fnc765/aki300yenLCD-raspico2w/hardware/review/compact-usbc-placement-2026-09-16/placement-3d.png

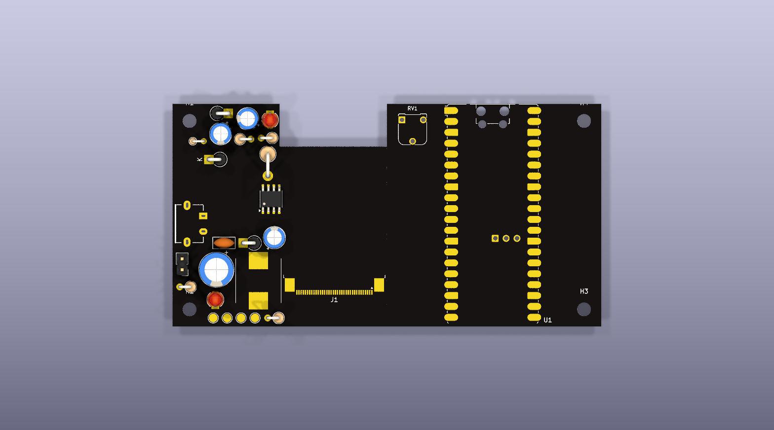
hardware/review/compact-usbc-placement-2026-09-16/placement-3d.png
