fnc765/aki300yenLCD-raspico2w/hardware/review/power-placement-2026-09-08/native-top.png

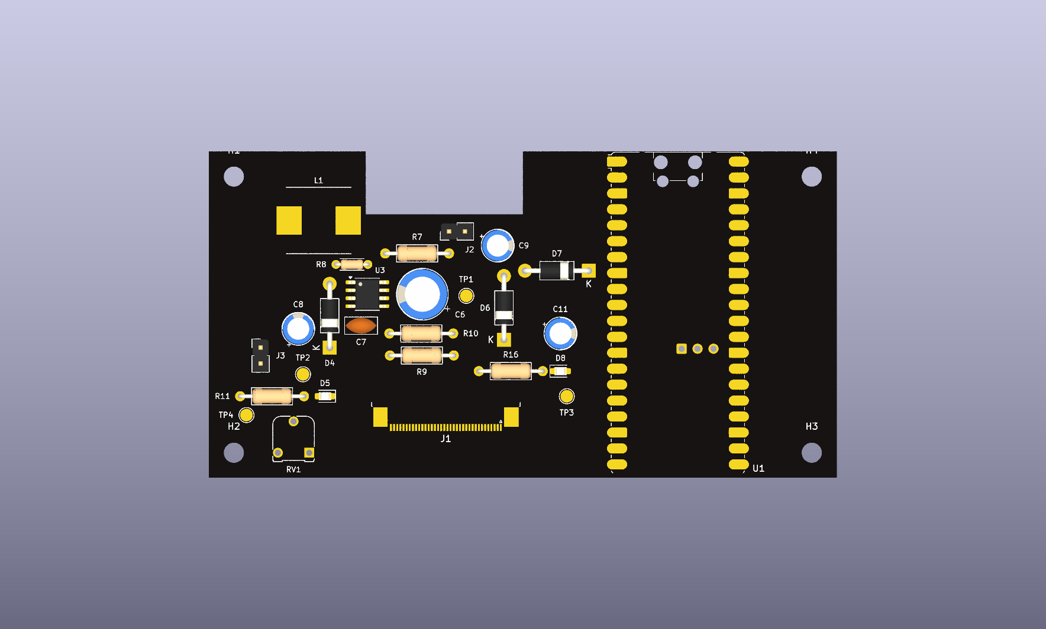
hardware/review/power-placement-2026-09-08/native-top.png
