fnc765/aki300yenLCD-raspico2w/hardware/power-placement-review.md

# 電源部の部品配置レビュー（2026-09-08、2026-09-16更新）

変更前を `f21348d` にコミットした後の配置・配線変更。基板は100×52 mm、上辺に既存の切り欠きを持つ。Pico/U1、LCD/J1、四隅の取付穴、Pico内の禁止領域、回路図・BOM・部品値・パッドのネット割当は保持した。電源関係24部品（コネクタ・テストポイント含む）をユーザー指定の赤枠領域だけへ移し、2026-09-16に電源部だけを配線した。Pico/U1とLCD/J1のフットプリントおよび配線領域には手を入れていない。RV1はユーザーが手動調整した `(53.5, 3.76) mm` を保持した。

## 調査と採用した方針

- [onsemi AN920、p.21](https://www.onsemi.com/pub/Collateral/AN920-D.PDF)：大電流ループを短く太くし、低電流の帰還／制御GNDとスイッチングGNDの戻りを入力コンデンサまで分ける。分圧抵抗をICへ近づける。
- [TI SLVA773、p.2–4](https://www.ti.com/lit/an/slva773/slva773.pdf)：昇圧では整流器・出力コンデンサ・スイッチのループを優先する。L1とSWノードを小さくまとめ、FBを離す。これは別ICを用いた一般的な昇圧配置指針なので、MC34063の実際の端子・外付けダイオードに読み替えた。
- [TI MC34063A、p.17](https://www.ti.com/lit/gpn/mc34063a)：帰還と入力デカップリング経路を短くする。掲載配置例は降圧であり、その形を昇圧基板へそのままコピーしていない。
- [onsemi MC34063 AN920](https://www.onsemi.com/download/application-notes/pdf/an920-d.pdf)：電流制限検出電圧は約330mV。R7=0.47Ωからピーク電流の設計目安を約0.70Aと見積もった。これは部品ばらつきとICしきい値を含まない配線幅選定用の概算である。
- [TI Working with Boost Converters, SNVA731](https://www.ti.com/lit/pdf/snva731)：スイッチ、整流ダイオード、出力コンデンサの高di/dtループを短く太くし、帰還を出力コンデンサ側から取り出す方針を採用した。
- [TI AN-1229, SNVA054C](https://www.ti.com/lit/an/snva054c/snva054c.pdf)：1oz銅箔・温度上昇20℃の例で4Aに約1.4mmを用いる資料を保守的な基準として参照した。本基板では約0.70A目安の主電力経路を1.0mm、端子・チャージポンプ・テスト経路を0.6mm、制御線を0.25～0.30mm、表示LEDだけを0.20～0.30mmとした。
- [Analog Devicesのスイッチングレギュレータ配置解説](https://www.analog.com/en/resources/technical-articles/basic-switchingregulatorlayout-techniques.html)：大電流の電力GNDと帰還・タイミングの静かな戻りを分け、最後に低インピーダンス面へ接続する考え方を採用した。
- [秋月電子 A295-CTRPB-1（116895）](https://akizukidenshi.com/catalog/g/g116895/)：5V入力を小型・低価格の電源専用Type-Cメスコネクタへ変更し、公式寸法図に基づく専用スルーホールフットプリントを作成した。基板左端からケーブルを挿せる向きでJ2を左外周へ配置した。
- [秋月電子 USB Type-C給電資料](https://akizukidenshi.com/goodsaffix/powered_by_type-c.pdf)：116895は内部にもCC1/CC2接点がなく、Type-C電源側からは給電されない。R17/R18を削除し、USB-A電源とA-to-Cケーブルで5Vを供給する前提を回路図・BOMへ明記した。

2026-09-16の赤枠制約更新では、部品のF.CrtYd全体が `X=0.4..26.6 mm, Y=0.4..51.6 mm` に入ることを必須条件にした。上辺切り欠き `X=25.0..26.6 mm, Y=0..10 mm`、固定したH1/H2/J1、および対象部品同士を障害物として扱い、数理配置では0.20 mm、最終読み戻しでは0.15 mmのコートヤード余白を確認した。U3/D4/L1/C8の昇圧ループ、D6/D7/C9/C11の反転電源経路、USB-CのVBUS/GND経路を重み付きで評価し、探索結果をKiCad DRCと画像で再確認して採用した。

アキシャル抵抗R7/R8/R9/R10/R11/R16はすべて縦置き、DO-41ダイオードD4/D6/D7もすべて縦置きに変更した。TP1～TP4は下外周に1列でまとめ、13V8端子J3は左外周へ配置した。密集領域の参照番号とD4/D7の極性文字はF.Fabへ移し、シルク重なりを避けた。

## 定量比較

数値はパッド中心の直線距離。実配線長や電源性能の測定結果ではない。

| 経路 | USB-C更新直後の仮置き mm | 最終配置 mm |
|---|---:|---:|
| U3 SW → D4 A | 94.792 | 5.029 |
| D4 K → C8 + | 89.985 | 4.757 |
| C8 GND → U3スイッチGND | 9.988 | 9.550 |
| L1 → U3 SW | 11.394 | 9.655 |
| R7検出側 → U3 pin7 | 66.007 | 4.505 |
| C6 → U3 VIN / GND | 12.838 / 21.209 | 12.695 / 17.739 |
| C7 → U3 pin3 | 7.548 | 4.187 |
| R9/R10 → U3 pin5 | 111.906 / 98.296 | 4.473 / 8.653 |
| C9 → D6/D7 | 96.109 / 103.728 | 4.054 / 8.818 |
| U3 SW → C9 | 12.726 | 11.287 |

小型USB-Cコネクタを含む24部品を赤枠内へ収め、実配線に合わせて最終配置を詰めた。主電力経路と空間のある±13V8主幹は1.0 mm、J1直下の制約部は0.60 mm、制御線は0.25～0.30 mm、低電流の表示LED分岐は0.20 mmとした。電源部とロジック部のGNDはF.Cu/B.Cu両面のベタへ更新し、パッドをサーマル接続、ビアをダイレクト接続とした。FBとタイミング回路はSWノードから離して独立配線した。C9は`SW_NODE`へ接続し、D6/D7/C9/C11の負電源経路を短くまとめた。表の数値はパッド中心距離であり、電源性能・温度・EMIの実測完了を意味しない。

## 検証と残件

- 2026-09-16 電源部配線後の最終ERCは0件。基板全体のDRCは13件、未配線は47件。電源部については短絡・同層交差・クリアランス・穴クリアランス・銅箔端・ダングリング・ソルダーマスクブリッジ・未配線がすべて0件。
- 対象24部品のコートヤードが赤枠内に完全に入り、上辺切り欠き・固定部品・対象部品同士とのコートヤード干渉が0件であることを、配置スクリプトの読み戻し検証で確認した。
- C9の＋端子を`+13V8`から`SW_NODE`へ修正し、回路図・基板・生成スクリプトを一致させた。出力ネットリストでもC9 pin 1、D4 pin 2、L1 pin 1、U3 pin 1が同じ`SW_NODE`に属することを確認した。
- D5/D8を3mm砲弾型THT LEDへ変更した。D5は秋月電子 111635（OSG5TA3Z74A、緑）、D8は111577（OSR5JA3Z74A、赤）で、フットプリントはともに`LED_THT:LED_D3.0mm`。C7は秋月電子 131236（RDE5C1H471J0P1H03B、470pF、50V、C0G、±5%、リード間隔2.5mm）をBOMへ反映した。
- J2は秋月電子116895（A295-CTRPB-1）へ変更し、J2 pin 1=`+5V`、pin 2=`GND`を確認した。CC端子は部品内部にも存在しないためR17/R18を削除した。USB-C電源とのC-to-C接続には使用できず、USB-A電源とA-to-Cケーブルを使う。
- 2026-09-16対象部品について、基板上のパッド番号とネット割当をKiCad読み戻しで確認した。
- 電源部配線時に残していたPico/LCD側47件の未配線は、後続の全体配線で解消した。U1/J1のフットプリント定義が入力基板から変化していないことも読み戻しで確認した。
- 2026-09-17の最終DRCに残る13件はライブラリ不一致9件、シルク端2件、禁止アイテム1件、シルク重なり1件。未配線、サーマル不足、短絡、クリアランス、穴クリアランス、銅箔端、ダングリング、ソルダーマスクブリッジは0件。
- 基板外にあった下書き注記と古い区切り線はDwgs.Userへ移した。文字・図形の内容は残した。

## 再現と出力

`place_power_stage.py`をKiCad 9付属のpython.exeで実行して固定配置を適用し、続けて`route_power_stage.py`で電源部だけを配線する。通常の更新では古い全体生成スクリプトから基板全体を再生成しない。両スクリプトとも`--input`と`--output`を指定でき、`--report`で配置・配線の検証記録を出力できる。配線スクリプトは既存トラック／ビアがある入力を拒否し、Pico/LCD側へ誤って追記しない前提を明示する。既配線基板への今回の差分は`upgrade_ground_power.py`でフェイルクローズに適用する。

`optimize_power_placement.py`は候補比較用。赤枠、上辺切り欠き、固定部品、コートヤード、重要な端子間距離、SW配線と感度の高い部品の交差を評価した。最終配置はDRCと画像確認を経て固定したもので、探索スコアだけで承認していない。

`review/power-placement-2026-09-08/`に最終DRC/ERC、検証JSON、KiCad純正SVG、その無加工ラスタライズPNG、純正3D PNGを保存。画面取得機能がWindows ACLエラーで起動できなかったため、画像はGUIスクリーンショットではなくKiCad公式出力。3Dモデルが未登録の部品は3D画像ではパッドのみになるため、実装外形は2D図で確認する。

2026-09-16更新分のERC、DRC、ネットリスト、KiCad純正SVGおよびPNGは`review/power-update-2026-09-16/`に保存した。

赤枠再配置の最終座標、境界検証、ERC/DRC、KiCad純正SVGと確認用PNGは`review/red-zone-placement-2026-09-16/`に保存した。

USB-C・縦置き・外周端子更新の最終座標、ネットリスト、ERC/DRC、KiCad純正SVGおよび3D PNGは`review/usbc-vertical-placement-2026-09-16/`に保存した。
秋月電子116895への小型化更新後の最終座標、ネットリスト、ERC/DRC、KiCad純正SVGおよび3D PNGは`review/compact-usbc-placement-2026-09-16/`に保存した。

電源部配線後の配置・配線レポート、ERC/DRC、検証JSON、KiCad純正SVGおよび3D PNGは`review/power-routing-2026-09-16/`に保存した。
