fnc765/aki300yenLCD-raspico2w/docs/datasheet-LTA042B010F.md

# LTA042B010F データシート（コミュニティ調査まとめ）

> **注意**: 東芝の正式データシートは非公開です。以下はコミュニティによるリバースエンジニアリング情報をまとめたものです。

## 基本仕様

| 項目 | 値 |
|---|-----|
| 型番 | LTA042B010F |
| メーカー | 東芝 (Toshiba) |
| パネル種別 | カラー TFT LCD |
| 解像度 | 400 × 96 ドット |
| パネルサイズ | 110mm × 30mm（横長） |
| 色深度 | RGB各6ビット（18ビット、約26万色） |
| インターフェース | RGB パラレル (RGB666) |
| コネクタ | 0.5mm ピッチ 40ピン FPC (実質36ピン使用) |
| バックライト | CCFL（冷陰極管）、専用インバーター必要 |
| 用途 | アミューズメント機器（パチンコ・パチスロ等） |
| 製造国 | 日本 |
| 発売時期 | 2006年12月 |

## 購入情報

| 項目 | 値 |
|---|-----|
| 販売店 | [秋月電子通商](https://akizukidenshi.com/catalog/g/g101703/) |
| 販売コード | 101703 |
| 価格 | ¥200（税込） |
| LCD+インバーターセット | [101705](https://akizukidenshi.com/catalog/g/g101705/) ¥300 |
| FPC DIP化基板 | [110187](https://akizukidenshi.com/catalog/g/g110187/) ¥300 |
| CCFLインバーター単体 | [111545](https://akizukidenshi.com/catalog/g/g111545/) ¥150 |

## ピンアサイン（CN1 / 40ピンFPC, 0.5mmピッチ）

| ピン | 記号 | 機能 | 備考 |
|---|---|---|---|
| 1 | TEST | テストパターン表示 | L=通常表示, H=テストパターン |
| 2 | NCLK | ドットクロック（ピクセルクロック） | **立ち下がりエッジ**でデータサンプル |
| 3 | GND | GND | |
| 4 | HSYNC | 水平同期入力 | |
| 5 | VSYNC | 垂直同期入力 | |
| 6 | 不明 | 不明（モード切替?） | **L固定推奨**、Hで挙動変化 |
| 7 | GND | GND | |
| 8 | B5 | 青データ MSB | |
| 9 | B4 | 青データ | |
| 10 | B3 | 青データ | |
| 11 | B2 | 青データ | |
| 12 | B1 | 青データ | |
| 13 | B0 | 青データ LSB | |
| 14 | GND | GND | |
| 15 | G5 | 緑データ MSB | |
| 16 | G4 | 緑データ | |
| 17 | G3 | 緑データ | |
| 18 | G2 | 緑データ | |
| 19 | G1 | 緑データ | |
| 20 | G0 | 緑データ LSB | |
| 21 | DVDD | ロジック用電源 | 3.3V or 5V |
| 22 | R5 | 赤データ MSB | |
| 23 | R4 | 赤データ | |
| 24 | R3 | 赤データ | |
| 25 | R2 | 赤データ | |
| 26 | R1 | 赤データ | |
| 27 | R0 | 赤データ LSB | |
| 28 | AVDD | アナログ用電源 | DVDDと同じ電圧推奨 |
| 29 | VCPP_ADJ | コントラスト微調整（Vo） | 0〜3V入力、入力Z≈10kΩ |
| 30 | GND | GND | |
| 31 | GVDD | LCDゲートドライバロジック電源 | 5V推奨 |
| 32 | GND | GND | |
| 33 | VSS | LCDゲート負電源 | **−9V〜−15V** |
| 34 | GND | GND | |
| 35 | VGON | LCDゲート正電源 | **+9V〜+15V** |
| 36 | GND | GND | |
| 37-40 | NC | 未使用 | |

> **注意**: 秋月電子の参考資料ではRGBのビット番号(MSB/LSB)が逆に振られている場合があります（naruken氏指摘）。上記は実測に基づく正確なアサインです。

### 信号配置の特徴

- **RGB の並び順**: B → G → R（ピン番号順）
- **DE（データイネーブル）信号は存在しない**: HSYNC/VSYNC モードのみ
- **NCLK は立ち下がりエッジ**でサンプリング（注意）

## タイミング仕様

### 水平タイミング

| パラメータ | Min | Typ | Max | 単位 | 備考 |
|---|-----|-----|-----|---|---|
| H active (表示期間) | 400 | 400 | 400 | clk | 固定 |
| H back porch | 107 | 107 | 107 | clk | HSYNC→表示開始 |
| H front porch | 3 | 97 | 197 | clk | 表示終了→次HSYNC |
| H total (1ライン) | 510 | 604 | 604 | clk | |
| H total (自動) | - | 560 | - | clk | 同期信号なし時 (107+400+53) |

### 垂直タイミング

| パラメータ | Min | Typ | Max | 単位 | 備考 |
|---|-----|-----|-----|---|---|
| V active (表示期間) | 96 | 96 | 96 | lines | 固定 |
| V back porch | 16 | 16 | 16 | lines | VSYNC→表示開始 |
| V front porch | 0 | - | N | lines | 可変、最小0 |
| V total (自動) | - | 561 | - | lines | 同期信号なし時 |

### 同期信号

| 信号 | 検出条件 | 動作 |
|---|---|---|
| HSYNC | NCLKの**立ち下がり**でサンプル、H→L遷移で同期開始 | Xアドレスリセット、Yインクリメント |
| VSYNC | HSYNC開始から**98クロック後**のNCLK立ち下がりでサンプル | X, Yアドレスリセット |

> **重要**: VSYNC は HSYNC 開始から 98 クロック後にサンプリングされる。任意のタイミングでアサートしても無視される。

### ピクセルクロック実用例

| フレームレート | H_total | V_total | DCLK |
|---|---|---|---|
| 30 Hz | 512 clk | 112 lines | **1.72 MHz** |
| 60 Hz | 512 clk | 112 lines | **3.44 MHz** |
| 60 Hz | 560 clk | 112 lines | **3.76 MHz** |

## 電気的特性

### 電源仕様

| 電源ピン | 電圧 | 備考 |
|---|---|---|
| DVDD (Pin 21) | 3.3V or 5V | ロジック電源。5V推奨（内部74HC590A使用） |
| AVDD (Pin 28) | DVDDと同じ | アナログ電源 |
| GVDD (Pin 31) | DVDDと同じ | ゲートドライバロジック電源 |
| VGON (Pin 35) | **+9V〜+15V** | ゲート正電源。高いと色保持時間が延びる |
| VSS (Pin 33) | **−9V〜−15V** | ゲート負電源。低いと色保持時間短い |

### 動作確認済み電源組み合わせ

| 構成 | DVDD | AVDD | GVDD | VGON | VSS | 入力レベル |
|---|---|---|---|---|-----|---|
| 5V構成 | 5V | 5V | 5V | +12V | -12V | CMOS |
| 3.3V構成A | 3.3V | 3.3V | 5V | +12V | -12V | LVCMOS |
| 3.3V構成B | 3.3V | 3.3V | 3.3V | +12V | -12V | LVCMOS |

> **Pico 2W (3.3V) との直接接続**: 3.3V構成B で動作可能。GVDD に別途 5V 供給が望ましい。

### コントラスト調整

- **VCPP_ADJ (Pin 29)**: 0〜3V のアナログ電圧で微調整
- 入力インピーダンス ≈ 10kΩ（低い）
- Vo=0V or Hi-Z にすると、値15付近で飽和 → **RGB各4bit（12bitカラー）** として使用可能
- **VR1（基板背面）**: フリッカー調整用。グレースケール表示でフリッカーが最小になるよう調整

### 内部IC

| IC | 型番 | 機能 |
|----|---|---|
| IC1 | KZ3H013304 | LCD タイミングコントローラ |
| IC2 | VHD04 | アナログ関連 |
| IC5 | 74HC590A | シフトレジスタ/カウンタ |
| TR2-TR5 | チップTr | ダイヤモンドバッファ（VCOM供給） |

## バックライト

| 項目 | 値 |
|---|-----|
| 種類 | **CCFL（冷陰極管）** |
| 駆動方式 | DC-ACインバーター（数百V AC） |
| 推奨インバーター | 秋月 DC12V冷陰極管インバーター (111545, ¥150) |
| 入力電圧 | DC 12V |
| 注意事項 | バックライトなしでは暗すぎて視認不可。高電圧に注意。 |

## 接続の簡易構成

### フル接続（18bit RGB666 + 制御）

```
[マイコン/FPGA]
  GPIO × 18本 → R[5:0], G[5:0], B[5:0]  (RGBデータ)
  GPIO × 1本  → NCLK (ドットクロック、タイマ出力推奨)
  GPIO × 1本  → HSYNC (水平同期)
  GPIO × 1本  → VSYNC (垂直同期)
  GPIO × 1本  → TEST (L固定)
  Pin 6       → L固定 (GND)
合計: 22 GPIO (TEST/Pin6をGND固定すれば20 GPIO)

[電源]
  +5V     → Pin 21(DVDD), Pin 28(AVDD), Pin 31(GVDD)
  GND     → Pin 3, 7, 14, 30, 32, 34, 36
  +12V    → Pin 35 (VGON)
  -12V    → Pin 33 (VSS)
  DC 12V  → CCFLインバーター → バックライト

[調整]
  Pin 29(VCPP_ADJ) → 可変抵抗(10kΩ)で 0〜3V
```

### 簡易接続（12bit RGB444 + 制御）

```
  R[3:0], G[3:0], B[3:0] = 12本
  R[5:4], G[5:4], B[5:4] = GND固定
  NCLK + HSYNC + VSYNC   = 3本
合計: 15 GPIO
Pin 29(VCPP_ADJ) = 0V or Hi-Z
```

## テストパターン機能

Pin 1 (TEST) を H にすると、G[5:0] の値でテストパターンを表示可能。
動作確認に便利。マイコンなしでもテストパターンで表示を確認できる。

## 重要な注意事項

1. **NCLKを停止してはいけない** — 液晶パネルが損傷する可能性（LTAシリーズ共通）
2. **バックライト(CCFL)は高電圧** — 感電注意、絶縁対策必須
3. **フレームバッファは内蔵されていない** — 常にリフレッシュデータを送り続ける必要がある。DMA必須
4. **秋月のピン番号に注意** — RGB の MSB/LSB が逆に振られている場合あり
5. **ダイヤモンドバッファ(TR2-TR5)** — ハンダ不良で電源ショートすると発煙。1個壊れると表示不可
6. **DC-DCコンバーターのノイズ** — ±12V生成時、液晶に表示ノイズが乗る可能性あり
7. **VGON/VSS電圧変更時** — VR1(フリッカー調整)の再調整が必要
8. **同期信号なしでも動作** — 560clk毎に自動リセットされるため、とりあえず映像出力可能

## 参考リンク

### 詳細解析サイト
- [なる研 (naruken) - LTA042B010F](http://naruken.cweb.tk/labo/lta042b010f/) — 最初の包括的解析
- [xcrosgs2wy - 秋月LCD解析](https://xcrosgs2wy.web.fc2.com/akilcd/) — 最も詳細な電気的解析

### 実装事例
- [pol - ESP32-S3で300円液晶](https://pol.hateblo.jp/entry/2023/11/27/001524) — ESP32-S3 LCD_CAMペリフェラル使用
- [mikanplus - STM32F103で300円液晶](https://www.usamimi.info/~mikanplus/stm32f/aki300.htm) — DMA+タイマで30Hz表示
- [Kyotani - AVR XMegaで300円液晶](https://kyotani-hobby.blogspot.com/2011/03/21.html) — 7回連載
- [ChaN (ELM) - 秋月3000円LCDレポート](https://elm-chan.org/junk/aki3k/report.html) — 比較・互換性検証

### 購入先
- [秋月電子 LCD単体](https://akizukidenshi.com/catalog/g/g101703/)
- [秋月電子 LCD+インバーターセット](https://akizukidenshi.com/catalog/g/g101705/)
