fnc765/aki300yenLCD-raspico2w/docs/ticker.md

# ネットワーク・ティッカー (`ticker`, v0.3.0〜、現行ソース v0.6.4)

0.6.0 で [P110M の Matter 消費電力表示](matter-power.md) を追加した。
前回の probe の登録情報を SD に引き継ぎ、Pico 2 W 単体で取得して LCD に W を表示する。

Pico 2 W + 300 円 LCD を「時計 + 天気 + 流れる文字」の小さな情報端末にする bin。
v0.4.0 から SD の写真 (BMP) をスライドショーで背景に敷き、その上に半透明の「ガラス」の板で情報を重ねる。
`wifi_ota` (v0.2.x) の後継で、**Release の OTA イメージはこれ** (`manifest.json` の `bin` が `ticker.bin`)。
OTA / TBYB の仕組みは [wifi-ota.md](wifi-ota.md) と同じ (実装は `src/ota/app.rs` に共通化した)。
v0.5.0 からは同じ LAN のブラウザで設定を変えられる (**設定ページ**、[settings-server.md](settings-server.md))。
0.5.1 からは流れる文字の後ろに毎周 `◆ 設定 http://192.168.x.y/ コード 123456 ◆` が流れる (§1.3) ので、その URL を開く
(`ticker.txt` の `show_settings=0` で入れない)。

## 1. 画面 (400×96、v0.4.0〜)

描画はハードウェアに依存しない `src/ui/` が行う。**同じコードを PC のシミュレータ `tools/ui-sim` で動かして、
書き込む前に PNG / GIF で確かめられる** ([ui-sim.md](ui-sim.md))。既定の構成 `layout=glass`:

```text
 x 8〜        y 4〜35   21:53:44   時計 (DejaVu Sans の 4 bit アンチエイリアス数字 32 px、秒は 15 px)。板なし、右下 1 px の影
              y 40〜53  9月29日(火) 日付 (東雲 14 px、影付き)
              (左上 230×70 は背景に薄い暗がりを焼き込み、明るい写真でも読めるようにする)
 x 234〜396   y 4〜57   天気のガラス板 (黒 62 % + 上辺 1 px の明るい線 + 角丸 4)
                          行 1: 天気アイコン 15×15 (晴れ / 月 / 晴れ時々くもり / くもり / 霧 / 霧雨 / 雨 / 雪 / 雷)
                                + 気温 (橙の AA 数字 19.1°)、右端に地名 (⌖東京)
                          行 2: 天気 (晴れ時々くもり、東雲 14 px)
                          行 3: ▲最高 (赤) ▼最低 (青) + 降水確率の錠剤 (💧40%、水色)
 x 4〜396     y 74〜92  流れる文字の帯 (ガラス、東雲 14 px、右→左) | 右端 118 px に小さな状態:
                          Wi-Fi の扇 + NTP WX MSG (緑 = 良好 / 黄 = 取得中 / 赤 = 失敗 / 灰 = 未取得) + v0.4.0
```

- 日本語は東雲フォント 14 ドットの等倍 (§5)。線はすべて 1 px (2 px の線は LCD のにじみで潰れるため)。
  時計・気温の数字だけは大きさが要るのでアンチエイリアスの数字フォント ([fonts/dejavu/README.md](../fonts/dejavu/README.md)) にした。
- 外周 1 px の枠は写真を全面に出すため `glass` / `dock` では描かない (表示位置 106 は v0.2.8 で確定済み。
  `classic` と `wifi_ota` には残っている)。
- 時刻同期前は `--:--` (灰) + `時刻同期中…`、天気取得前は `?` + `天気取得中…`。
- 18〜6 時は晴れ / 晴れ時々くもりのアイコンが月になる。
- `ticker.txt` の `layout=` で構成を選べる (シミュレータで比べた 3 案。v0.4.0 の既定は `glass`):

| `layout=` | 内容 |
|---|---|
| `glass` (既定) | 上記。写真の中央 (x 160〜230) と帯の上 (y 58〜73) が見え、情報は左上 (時計) / 右上 (天気) / 下 (文字) にまとまる |
| `dock` | 上 52 px は写真と時計 + 日付だけ、下 40 px のガラスの台に天気と流れる文字。写真が一番よく見えるが、天気が 1 行に詰まる |
| `classic` | 0.3.1 と同じ配置 (状態 3 行を常に表示) で、写真を全面 62 % 暗くして敷く。比較用 |

### 1.1 状態表示 (3 行 ⇔ 小さな 1 行)

0.3.1 の下 3 行 (`SSID IP | NTP | WX | MSG` / `ticker v0.4.0 via OTA slot B TBYB:...` / `OTA: ...`、`FONT_6X10`、9 px ピッチ) は
OTA の診断に欠かせないが画面の 3 分の 1 を使うので、**必要なときだけ** 下の帯の位置 (y 61〜95 のガラス板) に出す。
それ以外は帯の右端の小さな表示だけになる (流れる文字は 3 行の間は隠れる)。3 行を出す条件 (どれか 1 つ):

1. 起動から 60 s
2. 失敗から 30 s (NTP / 天気 / 文字の取得失敗、Wi-Fi の join 失敗、OTA の失敗、背景の写真が読めない)
3. 起動診断 (前回の TBYB の記録) / `ticker.txt` の注意を出している間 (60 s / 90 s)
4. Wi-Fi が IP を得ていない間
5. OTA のダウンロード中 / 検証中 / 再起動待ち (進捗バー付き) と、OTA の失敗・巻き戻り (`OTA:` 行が赤)
6. TBYB の buy 待ち (`TBYB:pending 41/180s wait:weather` / `settle 12s`、0.4.2〜 最長 180 s) / buy 失敗 / 締め切り切れ

`ticker.txt` の `status=full` で常に 3 行、`status=compact` で常に小さな 1 行 (既定 `auto` は上の規則)。
3 行の文言は 0.3.1 と同じ (下記)。

- 行 1: 起動診断 (前回の TBYB 起動の記録 `TBYB 0.3.0: dhcp-wait @121.3s ...`、無ければ `FLASH_UPDATE P1 A:... reset:wdt`
  の起動種別。電源投入直後の通常起動では出ない) → `ticker.txt` の注意 / 背景の写真の失敗 (`BG IMAGE.BMP: BMP: 24/32 bit only`) →
  `<SSID> <IP> | NTP <状態> | WX <状態> | MSG <状態>`
  - `NTP ok s1` = 同期済み (stratum 1)、`syncing`、`DNS failed` / `timeout` / `bad reply`
  - `WX ok` / `ok(http)` (TLS が通らず平文 HTTP に切り替えた) / `fetching` / `HTTP 429` / `bad JSON` / `too long`
  - `MSG ok` / `ok(cut)` (512 B で切った) / `fetching` / `HTTP 404` / ...
- 行 2・3 は `wifi_ota` の行 1・2 と同じ文言・色 (`src/ota/app.rs` が作る)。**OTA の診断はこの 2 行で行う**。
  ダウンロード中は行 3 の上に進捗バーが出る。

### 1.2 背景の写真 (スライドショー)

- SD のルートの `*.BMP` (8.3 名、名前順、最大 16 枚。`_` で始まる名前 = macOS の `._IMAGE.BMP` などは除く) を
  `slide=` 秒 (既定 30) ごとに切り替える。`images=A.BMP,B.BMP` で使う写真と順番を指定できる。
  1 枚だけ、または `slide=0` なら最初の 1 枚を出したまま。BMP が無ければ既定のグラデーション (紺 → 青紫)。
- 形式: **非圧縮の 24 bit / 32 bit BMP** (下から上 / 上から下のどちらも、32 bit は BI_RGB と標準マスクの
  BI_BITFIELDS)。8 bit (パレット) / 16 bit / RLE 圧縮 / PNG / JPEG は不可 (読めなければ状態行 1 に理由を出して次へ)。
- 大きさは任意 (最大 8192×8192)。**縦横比を保って 400×96 を覆う最小の倍率に拡大縮小し、はみ出た部分の中央を切り出す**
  (縮小は面積平均、拡大は最近傍)。ただし SD は遅い (下記) ので、**400×96 の 24 bit BMP (115 kB)** を勧める
  (`convert_image_to_bmp.py` で作れる。`sd_bmp_viewer` 用の `IMAGE.BMP` / `IMAGE2.BMP` はそのまま使える)。
- 背景用の RAM は 1 枚分 (RGB565 76.8 kB) しか無いので、切り替えは「背景だけを 0.5 s で暗くする → 暗いまま
  新しい写真を読みながら行を上書き (下から上の BMP なら下の行から現れる) → 0.7 s で明るく戻す」。
  時計 / 天気 / 流れる文字は通常の明るさのまま動き続ける。8 bit の色は Bayer 4×4 のディザで RGB565 にする。
- 読み込みの速さ: SD は GPIO のビットバング SPI。起動時 (wifi.txt / ticker.txt) は従来どおり ≈200 kHz、
  写真を読むときだけ ≈1.5〜2 MHz に上げる (`sdfast=1`、既定)。400×96 の BMP で ≈1〜2 s の見込み。
  読み誤り (CRC) が出たら自動で低速に戻して読み直す (低速だと ≈4〜5 s、その間は描画が 30 fps に落ちる)。
  1 回に読むのは 512 バイト (SD の 1 ブロック) までで、描画 1 フレームの合間に 5 ms まで読むので、読み込み中も
  時計と流れる文字は止まらない。
- OTA の確認 / ダウンロード / 検証の間は切り替えを始めず、読み込み中なら止まって待つ (フラッシュ書き込みと重ねない)。

### 1.3 流れる文字の設定 URL とコード (0.5.1〜)

設定ページ ([settings-server.md](settings-server.md)) の URL とアクセスコードを、流れる文字の後ろに毎周入れる:

```text
…流れる文字…　◆　設定 http://192.168.200.130/ コード 482913　◆　…流れる文字…　◆　設定 …
                 橙  灰    水色                    灰     水色      橙
```

- 設定の部分があるときは文字列 (文字 + 区切り + 設定 + 区切り) を **切れ目なく繰り返して** 流す (末尾の ◆ のすぐ後に先頭が続く。
  つなぎ目で位置が飛ばない。`scroll::advance` は 1 周進んだら 1 周分戻すだけ、描画は周期ごとに並べる)。文字が空なら設定の部分だけが流れる。
  設定の部分が無いとき (`show_settings=0` など) は 0.5.0 までと同じ (右端から入って左へ出切ったら右端から)。
- 入れるのは **設定ページが待ち受けている間だけ** (最初の OTA 確認が通った後。回復モードでは入れない)。IP が無い間 (Wi-Fi が切れた)
  は `設定: Wi-Fi 接続待ち`。IP / コードが変わったら次のフレームで組み直す (流れている位置はそのまま。文字が変わったときだけ右端から)。
- `ticker.txt` の `show_settings=0` (設定ページの「流れる文字に設定 URL とコードを入れる」) で入れない。
- 設定ページの「LCD にコードを表示」: 流れる文字を設定の部分が左端に来る位置へ進め、12 s だけ薄い水色の板で目立たせる。
  その後 1 分は `show_settings=0` でも入れる。状態 3 行を出している間 (起動 60 s、buy 待ちなど) は、0.5.0 と同じく行 1 にも
  `settings: http://… code …` を 1 分出す (待ち受けの開始時も)。
- Glass の帯 (264 px) には 1 度に全部は入らない (≈ 294 px)。URL の先頭からコードの末尾までは 259 px で収まる。Dock / Classic は全部見える。
- 組み立ては `src/ui/scroll.rs` の `ScrollText::compose` (static な共有モデルの中、≈ 0.8 kB。スタックには置かない)。文字 (最大 512 B) +
  設定の部分 (最大 67 B) が必ず入る大きさ (608 B) で、足りなければ文字の方を文字の境目で切る。描画タスクは入力 (文字の世代、
  URL / コードの世代、設定の部分の状態) が変わったフレームだけ組み立て直し、毎フレームは見えている部分だけを描く。
  ホストのテスト (`tools/ticker-tests` の `scroll_tests`) と ui-sim (`scenarios/settings*.json`) も同じコードを使う。

### 1.4 電力を大きく表示する・推移を見る (0.6.3〜)

設定ページの「電力表示」で通常 / 大きく / 大きく＋グラフを選べる。
`power_display=normal` は従来の配置。`large` は左側の広い枠に W を右寄せで大きく表示する。
`graph` は左側の136pxの枠に現在値を右寄せし、右の時計と高さを揃える。
数値の下に `P110M` と状態表示、余白を空けてその下に推移を表示する。
右側の時計・日付・天気の枠は右端を固定し、表示中で一番広い行に左右6pxの余白を加えた幅になる。
天気アイコン・気温・降水確率もまとめて一行として測り、天気の説明がより長ければそちらに合わせる。
詳細表示で隠れる説明は幅に含めない。グラフ表示では中央に120px以上の背景が見える余白を確保する。
両モードとも気温の右に水滴と今日の降水確率を表示する。未取得は `--%` (0% と区別)。
大型表示では Glass の下部帯を使い、状態表示とスクロールの切り替え条件 (§1.1) は同じ。
状態 3 行を表示中は上の枠を縮め、数値とグラフも収める。Matter が無効なら従来の画面を使う。

「グラフ期間」は **1分・5分・30分・1時間・6時間・24時間**。
`power_minutes=1/5/30/60/360/1440` でも設定でき、既定は 5分。
横軸は選んだ期間の過去から現在、縦軸は W (0 を含む自動調整)。未取得・通信が途切れた区間は線をつながない。
非常に大きな縦軸の値は `k` / `M` (千倍 / 百万倍) で短く表し、数字がプロット領域に重ならないようにする。

履歴は通常表示中も RAM に蓄積し、表示・期間の変更では消えない。再起動・電源断で消える。
短い期間は 5秒、6・24時間は 2分の平均値を使い、履歴・描画用の集計結果で約6.5KBの固定領域を使う。
集計は新しい取得値・期間変更・5秒の経過時だけ行い、毎フレームの通信や SD 書き込みは増やさない。
時計の時刻修正に左右されないよう、履歴の時間は起動からの経過時間で管理する。
設定ページ上のグラフは配置確認用のサンプル値で、実際の測定履歴は LCD に表示する。

## 2. データ源と更新周期

| 項目 | 取得先 | 方式 | 周期 | 失敗時 |
|---|---|---|---|---|
| 時刻 | `ntp.nict.jp` → 予備 `pool.ntp.org` (UDP 123) | SNTP v4 (RFC 4330、48 B、自前実装 `src/ticker/sntp*.rs`) | 6 時間 | 30 s → 最大 10 min |
| 天気 | `api.open-meteo.com/v1/forecast` (API キー不要) | HTTPS (TLS 1.3 / AES-128-GCM / RSA-PSS、GitHub と同じ設定)。TLS 失敗時は次回から `http://` (Open-Meteo は平文も受ける) | 30 分 | 2 分 |
| 流れる文字 | `ticker.txt` の `message_url` (既定: このリポジトリの `ticker/message.txt`、raw.githubusercontent.com) | HTTPS (200 直返し、リダイレクト無し) | 5 分 | 1 分 |
| OTA | GitHub Release の `manifest.json` → `ticker.bin` | HTTPS (wifi_ota と同じ) | 60 秒 | 60 s → 最大 10 min |

- 時刻は同期時の UNIX ミリ秒 + embassy の単調時計 (`Instant`) で進める。表示は固定オフセット
  (`ticker.txt` の `tz`、既定 +9 = JST)。夏時間は扱わない。
- 天気の要求は `current=temperature_2m,weather_code&daily=temperature_2m_max,temperature_2m_min,
  precipitation_probability_max&timezone=auto&forecast_days=1` (本文 ≈ 620 B、chunked)。
  `serde-json-core` で `current` / `daily` だけ読む。WMO 天気コードは `src/ticker/weather.rs` で
  日本語にする (0 快晴、1 晴れ、2 晴れ時々くもり、3 くもり、45/48 霧、51〜55 霧雨、61/63/65 小雨/雨/大雨、
  71/73/75 小雪/雪/大雪、80〜82 にわか雨、95 雷雨、96/99 雷雨とひょう …)。
  Open-Meteo の無料枠は 1 日 10,000 要求 / IP なので 30 分周期 (48 回/日) は十分余裕がある。
- 流れる文字は UTF-8 テキストをそのまま 1 行に流す (改行は空白に)。512 バイト (日本語 ≈ 170 文字) で切る。
  内容が変わったときだけ右端から流し直す。**`ticker/message.txt` を main で書き換えれば、5 分以内に
  全機体の表示が変わる。**
- 取得は 1 本の TLS バッファ (16 kB + 3 kB) を共用するため、取得タスク `jobs_task` (250 ms 周期、0.4.1〜。
  0.4.0 までは main ループ) が OTA → NTP → 天気 → 文字 の優先順で**一度に 1 つずつ**行う。OTA のダウンロード中
  (数十秒〜数分) は他の取得は待つ。
- **接続後の最初の仕事は OTA 確認** (0.4.1〜)。最初の確認が終わる (成否を問わない) まで NTP / 天気 / 文字も
  写真の読み込みも始めない。新しい版にどこかで止まる不具合があっても、起動するたびに OTA 確認までは
  進むので、次の版を配れば直る (§8)。Wi-Fi が無い / つながらない場合、写真は起動 45 s 後に始める。

## 3. TBYB と OTA

- 自己診断 (buy 条件) は 0.4.2 から「Wi-Fi + DHCP、OTA の manifest 確認 (TLS + HTTP)、NTP / 天気 / 文字 / SD の設定 /
  最初の写真を 1 回ずつ試す (0.5.0〜 設定ページの待ち受け開始も)、その後 25 s 健全に動く」(締め切り 180 s、§8.2)。0.4.1 までは Wi-Fi + DHCP だけで、
  OTA 確認より前に buy していた (OTA の経路が壊れた版でも buy してしまう)。取得の成否は問わない (落ちずに戻ってくればよい)。
- buy 待ちの間 (OTA で届いてから 40〜60 s。状態行 2 が黄色の `TBYB:pending 41/180s wait:message` → `settle 12s`) は、
  時計・天気・文字・写真は普段どおり動く。OTA 確認は manifest を読むだけ (buy の後にダウンロード)。
- OTA イメージの切り替え: v0.2.x の `wifi_ota` は manifest の `bin` に書かれた名前をそのまま
  `releases/latest/download/<bin>` から取る (`src/ota/app.rs` の `latest_asset_url(&manifest.bin)`)。
  v0.3.0 の Release では `manifest.json` が `ticker.bin` を指すので、**0.2.8 の `wifi_ota` が動いている機体は
  そのまま `ticker` 0.3.0 をダウンロードして切り替わる**。以後の版も `ticker.bin` で配る。
  `wifi_ota.bin` / `wifi_ota.uf2` (TBYB 付き) も Release には引き続き付けるが、manifest からは参照しない。
- `ticker` から `wifi_ota` に戻したいときは USB (`wifi_ota-plain.uf2`) で書くか、manifest の `bin` を
  `wifi_ota.bin` にした Release を出す (版数は上げる必要がある)。

## 4. 設定: SD カードの `ticker.txt` (任意)

`WIFI.TXT` と同じく microSD のルートに置く (8.3 名 `TICKER.TXT`、UTF-8、BOM 可、1,536 バイトまで (0.5.0〜。0.4.x は 512))。
0.5.0 からは **設定ページ** ([settings-server.md](settings-server.md)) からも書き換えられる。ページは変えたキーの行だけを書き換え、
知らないキー / コメント / 行の順番は残す (書き込みは `TICKER.NEW` → 読み戻し → `TICKER.BAK` → `TICKER.TXT` → 読み戻し。
`TICKER.TXT` が無い / 空で `TICKER.NEW` があれば、起動時にそれを読む)。無ければ東京の既定値で動き、
起動後しばらく (起動診断の 60 s の後) 状態行 1 に `ticker.txt not found, using Tokyo (35.6812,139.7671 UTC+9)` と出る。

**ticker.txt は無くても止まらない**。無い / 空 / 読めない / SD カードが無い、のどの場合も既定値で起動を続け、
状態行 1 に理由を出すだけ (`ticker::config::load`、4 つの場合を `tools/ticker-tests` で確認している)。
0.4.0 が起動後 1 分ほどで固まったのは ticker.txt とは関係なく、最初の HTTPS (天気) でスタックが溢れたため (§8)。

| SD の状態 | 状態行 1 の注意 |
|---|---|
| `TICKER.TXT` が無い | `ticker.txt not found, using Tokyo (...)` |
| 空 (空白 / 改行だけ) | `ticker.txt is empty, using Tokyo defaults` |
| 有効なキーが無い / UTF-8 でない | `ticker.txt: no valid keys, using Tokyo defaults` |
| 読み取り失敗 | `ticker.txt: <理由>, using Tokyo defaults` |
| SD カードが無い / 初期化できない | `SD: SD INIT FAILED (ticker.txt skipped, using Tokyo)` (Wi-Fi も `wifi.txt` が無いので OTA 無し) |

```ini
# 行頭 # はコメント。key=value、キーの大文字小文字は区別しない。値の後ろの # 以降も無視
lat=35.6812          # 緯度 (-90〜90)
lon=139.7671         # 経度 (-180〜180)
tz=+9                # UTC からの時差 (時間)。9 / -5.5 / +05:30 / 9:00 の形も可。±14 まで
place=東京           # 天気の行の先頭に出す地名 (最大 32 バイト、東雲フォントにある文字)
message_url=https://raw.githubusercontent.com/fnc765/aki300yenLCD-raspico2w/main/ticker/message.txt
scroll=1             # 流れる文字の速さ (px / フレーム、1〜8。60 Hz なので 1 = 60 px/s)
slide=30             # 写真の切り替え間隔 (秒、5〜3600。0 = 切り替えない)          v0.4.0〜
images=IMAGE.BMP,IMAGE2.BMP   # 背景に使う BMP と順番 (省略時はルートの *.BMP 全部、名前順)
layout=glass         # 画面構成 glass / dock / classic (§1)
rotate=0             # 画面全体の向き: 通常 0 / 180度回転 180
power_display=normal # 電力表示: normal / large / graph (大きく＋グラフ、§1.4)
power_minutes=5      # グラフ期間 (分): 1 / 5 / 30 / 60 / 360 / 1440
status=auto          # 状態 3 行 auto (必要なときだけ、§1.1) / full (常に) / compact (常に小さな 1 行)
sdfast=1             # 写真を読むときの SD の速さ 1 = 速い (読み誤りで自動的に低速へ) / 0 = 常に低速
debug_crash=ota      # 試験用 (0.4.2〜): boot / ota / slideshow でわざと panic する (回復モードの確認用、§8)。既定は無し
message=こんにちは   # 流れる文字をこの端末で決める (0.5.0〜)。行末まで全部 (# もそのまま)。あれば message_url を取得しない
show_settings=1      # 流れる文字に設定ページの URL とアクセスコードを入れる (0.5.1〜、既定 1)。0 で入れない
```

| キー | 既定値 | 備考 |
|---|---|---|
| `lat` / `lon` | 35.6812 / 139.7671 (東京駅) | Open-Meteo に小数 4 桁で渡す |
| `tz` | +9 | 表示だけに使う。天気の「今日」は Open-Meteo が座標から決める (`timezone=auto`) |
| `place` | 東京 | 空なら既定のまま |
| `message_url` | 上記 | `http://` / `https://` で始まること。最大 256 バイト |
| `scroll` | 1 | |
| `power_display` | normal | 大型表示 `large` / グラフ付き `graph`。Matter が無効なら従来の画面 |
| `power_minutes` | 5 | 1 / 5 / 30 / 60 / 360 / 1440 (分)。表示の変更でも履歴は残る |
| `slide` | 30 | 0 なら最初の 1 枚のまま (v0.4.0〜) |
| `images` | (ルートの *.BMP) | カンマ区切り、8.3 名、最大 16。正しい名前が 1 つも無ければ無視 |
| `layout` | `glass` | `glass` / `dock` / `classic` |
| `rotate` | 0 | `0` = 通常、`180` = 画面全体を180度回転。デバイスを逆さに置く場合に使う。設定ページから保存すると次のフレームから反映し、再起動後も保持する |
| `status` | `auto` | `auto` / `full` / `compact` |
| `sdfast` | 1 | `0` / `1` |
| `message` | (無し) | 0.5.0〜。512 バイトまで。空 / 行が無ければ `message_url` から取得。設定ページの「この端末で決める」が書く |
| `show_settings` | 1 | 0.5.1〜。`0` / `1`。設定ページの「流れる文字に設定 URL とコードを入れる」が書く (§1.3)。**1 の間は LCD を見られる人なら誰でも設定を変えられる** ([settings-server.md §4](settings-server.md)) |
| `debug_crash` | (無し) | `boot` (ticker.txt を読んだ直後) / `ota` (最初の OTA 確認の直前) / `slideshow` (最初の写真を読み始めたとき) / `none`。**buy 済みの版の通常起動でだけ効く** (TBYB の buy 待ちと回復モードでは無視。回復モードは ticker.txt を読まない)。2 回で回復モードになり、10 分ごとに通常モードを試してまた落ちる。消せば次の通常モードの試行で元に戻る |

不正な値のキーは無視して既定値のまま。有効なキーが 1 つも無ければ `ticker.txt: no valid keys, ...` と出る。

## 5. 日本語フォントとライセンス

- /efont/ プロジェクトの**東雲フォント** (Shinonome) 0.9.11、ゴシック体 14 ドット (`shnmk14` JIS X 0208 全角 14×14 +
  `shnm7x14r` JIS X 0201 半角 7×14) を `tools/bdf2bin.py` で 3 つのテーブル (`fonts/shinonome/codes.bin` 14,094 B +
  `glyphs.bin` 197,316 B + `widths.bin` 7,047 B、計 218,457 B、7,047 グリフ = JIS 第一・第二水準 + かな + 記号 +
  半角 ASCII / 半角カナ) に変換し、フラッシュに埋め込む (`src/font/shinonome.rs`、Unicode の二分探索、等倍描画)。
  取得元は Debian / Ubuntu の `xfonts-shinonome` パッケージ (PCF → `pcf2bdf`)。
- ライセンスは **Public Domain** (作者が権利を行使しないと宣言。改造・変換・組込み・再配布自由、無保証)。
  原文は [fonts/shinonome/LICENSE](../fonts/shinonome/LICENSE)、由来は [fonts/shinonome/README.md](../fonts/shinonome/README.md)。
- **v0.3.1 で美咲フォント (8×8) の 2 倍表示から置き換えた理由**: 実機の写真で、2 倍にした線 (2 px) が
  隣の線との隙間 (2 px) を LCD の画素のにじみで埋めてしまい、「太すぎて潰れて」見えた。ASCII の `FONT_6X10` や
  時計の数字 (5×7 ×4 は線が 4 px だが隙間も 4 px) は問題なかったので、線 1 px・隙間 1 px 以上の等倍 14 ドット
  フォントに変えた。文字の大きさ (全角 14 px) は美咲 ×2 の字面 (7×7 ×2 = 14 px) と同じで、レイアウトは変えていない。
  16 ドットの東雲 (`shnmk16`) も検討したが、字面が 16 行を使い切るため 16 px の帯に余白が取れず、区切り線や
  隣の行と接してしまうので 14 ドットにした。
- 収録外の文字 (絵文字など) は `□` で描く。半角 (ASCII、半角カナ) は 7 px 幅、全角は 14 px 幅。
  `～` (U+FF5E) と `〜` (U+301C)、`－` (U+FF0D) と `−` (U+2212)、`¥` と `\` は同じグリフ。

## 6. 構成

```text
src/bin/ticker.rs        main (ウォッチドッグ → 起動の方針 → LCD → SD → USB → CYW43 → 250 ms ループ: 接続 / TBYB / 状態行 / OTA の再起動)
                         jobs_task (0.4.1〜、250 ms: 最初に OTA 確認、以後 OTA / 設定ページの要求 (0.5.0〜) / NTP / 天気 / 文字を 1 つずつ。
                         0.4.2〜 回復モードのときは回復モード全体 = 画面 + Wi-Fi + 60 s ごとの OTA、§8.3)
                         recovery_render_task (回復モードの画面)、fallback_now (他方区画へ、§8.4)
                         render_task (垂直同期ごとに全画面を描き直し、文字を scroll px 動かす。状態 3 行の規則 §1.1)
                         panic / HardFault / DefaultHandler (記録してリセット、§8)
src/supervisor.rs        ウォッチドッグ (0.4.2〜 main の最初から) + 生存確認 + buy 待ちの締め切り + MSPLIM + スタックの塗り (§8)
src/boot_policy.rs       起動の方針 (通常 / 回復 / 他方区画)、buy 条件、SCRATCH の語、data 区画の記録 (0.4.2〜、純粋、§8)
src/persist.rs           data 区画の記録の読み書き (Wi-Fi の資格情報の写し、入れない版。0.4.2〜)
src/noinline.rs          大きな future の poll をインライン展開させない包み (スタック対策、0.4.2〜)
src/ticker/health.rs     止まったタスクの判定、`last reset: ...` の文字列 (純粋、ホストのテストあり)
src/web/                 設定ページ (0.5.0〜、settings-server.md): server.rs (待ち受け、要求の処理、SD の読み書き、ticker.txt の安全な書き換え)、
                         http.rs / form.rs / auth.rs / upload.rs / json.rs (純粋、ホストのテストあり)。web/settings/index.html を build.rs が gzip で埋め込む
tools/settings-mock/     設定ページの偽の端末 (mock_server.py) と画面写真 (screenshots.mjs、Playwright)
scripts/stack-report.py  ELF の逆アセンブルから各タスクの最悪スタック深さを見積もる (§7.1)
                         共有モデル MODEL (ThreadModeRawMutex + RefCell。main が文字列を入れ、render が読む)
src/ticker/slideshow.rs  背景の写真 (SD の BMP を 1 ブロックずつ読む、フェード、OTA 中は停止。§1.2)
src/ui/                  画面の描画 (no_std の純粋なコード。tools/ui-sim と共用): screen.rs (3 つの構成)、scroll.rs (流れる文字の組み立て、0.5.1〜)、recovery.rs (回復モード)、
                         canvas.rs (ガラス板 / 文字 / アイコン)、bmp.rs (BMP → 400×96、拡大縮小 + 切り出し + ディザ)、
                         color.rs (RGB565 / 666 / 888、合成)、aafont*.rs (AA 数字)、icons.rs、background.rs、slide.rs
tools/ui-sim/            画面シミュレータ (PNG / GIF、docs/ui-sim.md)
src/ota/app.rs           OTA + TBYB + 接続管理 (wifi_ota から移動。wifi_ota と共用)
src/ticker/civil.rs      UNIX 秒 → 年月日 / 曜日 / 時分秒 (Hinnant の civil_from_days)
src/ticker/config.rs     ticker.txt
src/ticker/weather.rs    Open-Meteo の URL / JSON / 天気コード
src/ticker/sntp.rs       SNTP パケット (純粋)、sntp_net.rs: embassy-net での問い合わせ
src/ticker/digits.rs     5×7 の数字 (0.3.x の時計。v0.4.0 の画面では使わない、テストのみ)
src/font/shinonome.rs    東雲フォント (14 ドット) の検索と描画
tools/bdf2bin.py         BDF → テーブル (JIS X 0208 / JIS X 0201 / Unicode 符号の BDF に対応)
tools/ticker-tests/      上の純粋なモジュールをホストでテストする (cd tools/ticker-tests && cargo test)。
                         boot_sim.rs は起動の流れの模擬 (故障の注入、§8.7)。CI の build ジョブで毎回走り、失敗すれば Release も作られない
ticker/message.txt       流れる文字の既定の取得元
```

描画は毎フレーム (≈16.6 ms) 全画面をバックバッファへ描き直して `present()` (垂直ブランキングでフロントへ
コピー) するので、スクロールにティアリングは出ない。v0.4.0 の 1 フレーム: 背景のコピー (76.8 kB の memcpy ≈0.2 ms)
+ ガラス板 2 枚の半透明合成 (≈16,000 画素 × ≈12 サイクル ≈1.3 ms) + AA 数字 / 文字 / アイコン (≈0.5 ms) の
見積り ≈2〜3 ms (150 MHz)、垂直ブランキングのコピー (RGB565 → 走査ワードの表引き、≈7 サイクル / 画素、≈2.4 ms) を
足して ≈5 ms / 16.6 ms。暗がりは写真を読んだときに 1 回だけ背景へ焼き込み、毎フレームは計算しない。
実測値は defmt のログ `render: max N us per frame` (30 s ごと) に出る。流れる文字は LCD のフレーム番号で進めるので、
描画が 1 フレーム遅れても速さは変わらない (2 px 飛ぶだけ)。フラッシュ書き込み中 (OTA のダウンロード中、1 セクタごとに 45〜400 ms 割り込み禁止) は描画が
止まり文字が一瞬引っかかるが、走査 (SRAM の DMA リング) は乱れない。

## 7. RAM / フラッシュ (`--features tbyb`、`llvm-size`)

| bin | `.text` + `.rodata` | `.data` + `.bss` + `.uninit` | スタック |
|---|---|---|---|
| `ticker` 0.5.1 | 872,084 + 556,808 = 1,428,892 B ≈ **1,395 kB** (`ticker.bin` 1,434,580 B、0.5.0 より −176 B) | 5,340 + 490,540 + 1,024 = 496,904 B (+808 B: 流れる文字の組み立て `ScrollText` を共有モデルに) | **35,572 B ≈ 34.7 KiB** (§7.1) |
| `ticker` 0.5.0 | 874,108 + 555,748 = 1,429,856 B ≈ **1,396 kB** (1 スロット 1920 kB の 73 %、設定ページ +120 kB) | 4,540 + 490,532 + 1,024 = 496,096 B | **36,380 B ≈ 35.5 KiB** (§7.1) |
| `ticker` 0.4.2 | 778,288 + 531,536 = 1,309,824 B ≈ **1,279 kB** (1 スロット 1920 kB の 67 %) | 4,144 + 489,168 + 1,024 = 494,336 B | **38,144 B ≈ 37.2 KiB** (§7.1) |
| `ticker` 0.4.1 | 726,380 + 528,992 = 1,255,372 B ≈ **1,226 kB** (1 スロット 1920 kB の 65 %) | 4,144 + 486,848 + 1,024 = 492,016 B | **40,464 B ≈ 39.5 KiB** (0x2008_2000 まで、§7.1) |
| `ticker` 0.4.0 | 720,720 + 528,348 = 1,249,068 B ≈ **1,220 kB** (1 スロット 1920 kB の 65 %) | 4,136 + 491,024 + 1,024 = 496,184 B | ≈ **27.4 kB** |
| `ticker` 0.3.1 | 677,772 + 515,768 = 1,193,540 B ≈ 1,166 kB (61 %) | 2,064 + 483,056 + 1,024 = 486,144 B | ≈ 37.3 kB |
| `wifi_ota` 0.4.1 | 629,176 + 280,744 = 909,920 B | 2,628 + 405,472 + 1,024 = 409,124 B | ≈ 120.5 KiB (+8 kB、SRAM8/9) |
| `wifi_ota` 0.4.0 | 629,404 + 280,680 = 910,084 B | 2,628 + 405,472 + 1,024 = 409,124 B | ≈ 112 kB |

**v0.4.0 の RAM の組み替え**: 写真の背景 (400×96) を持つには 1 枚分のバッファが要るが、0.3.1 の空きは ≈37 kB しか無く、
RGB666 ワード (`u32`) のままでは 153.6 kB、RGB565 でも 76.8 kB で入らない。そこで

- LCD のバックバッファ (`lcd::display::BackBuffer`) を **RGB666 の `u32` (153,600 B) から RGB565 の `u16` (76,800 B)** にし、
- 空いた 76.8 kB に背景 `ticker::slideshow::BG` (RGB565、76,800 B) を置いた。
- 垂直ブランキングのコピー (`present()`) は 2 つの 256 語の表 (上位バイト / 下位バイトの寄与、SRAM に 2 kB) の OR で
  RGB565 → 走査ワード (RGB666、ビット順反転込み) に広げる。1 行 ≈ 20〜25 µs で、走査の 1 行 147 µs より十分速いので、
  ブランキング中に始めれば 0.3 までの単純コピーと同じく走査に追い越されない。R/B は 5 bit になる (上位ビットの複製で 6 bit に
  広げる) が、写真は 8 bit からディザを掛けて RGB565 にするので縞は目立たない。フロントバッファ (DMA が走査する
  509×113 ワード、230 kB) と走査の仕組み (VISIBLE_X_OFFSET = 106 を含む) は変えていない。
- 他の bin (`wifi_ota` / `wifi_status` / `ota_selftest` / `sd_bmp_viewer`) も同じ `BackBuffer` を使うので RAM が 76.8 kB 空いた。
  見た目の違いは R/B の最下位ビットだけ。

増分 (ticker 0.3.1 → 0.4.0): RAM +10 kB (スライドショーのタスク 6.7 kB = 行の累積 3.2 kB + 512 B の読み込みバッファ + 一覧、
表 2 kB、他)。スタックの目安 ≈27 kB (TLS / HTTP のバッファは static で、0.3.1 と同じ)。フラッシュ +55 kB (描画コード、AA 数字 5.6 kB、BMP)。
**この 27 kB が足りなかった** (§7.1、§8)。

### 7.1 スタック (0.4.1〜)

cortex-m-rt の配置では、スタックは RAM の最上位から下へ伸び、その下は `.uninit` (defmt の RTT バッファ 1 kB) と
`.bss` の最上位 (`lcd::display::FRAME_WAKER` / USB の waker / 写真の背景 `BG` の末尾) にそのまま接している。
0.4.0 までは溢れても何も検出しなかった。

見積もりは `scripts/stack-report.py <ELF>` (逆アセンブルの `push` / `sub sp` からフレームの大きさ、`bl` から呼び出し
グラフを作り、各タスクの poll からの最深経路 + 割り込み 1 段 + 例外フレームを足す。`TlsVerify::None` では呼ばれない
証明書検証の経路は除く。関数ポインタ経由の呼び出しは追えないので下限の見積もり):

| 版 | 空きスタック (`_stack_start` − `__euninit`) | 最深経路 (+ 割り込み) | 余裕 |
|---|---|---|---|
| 0.3.1 | 38,144 B | 34,608 B: main の poll 13.3 kB → `fetch_small` 4.8 kB → reqwless `request` 7.5 kB → TLS ハンドシェイク (P-256) | +3.5 kB |
| 0.4.0 | 28,104 B | 35,072 B: 同じ経路 (main 14.0 kB) | **−7.0 kB (溢れる)** |
| 0.4.1 | 40,464 B | 24,868 B: `jobs_task` の poll 5.4 kB → `fetch_small` 2.8 kB → `request` 7.5 kB → TLS | **+15.6 kB** |
| 0.4.2 | 38,144 B | 24,444 B: `jobs_task` (通常の取得 + 回復モード) の poll 2.7 kB → OTA 確認 2.9 kB → `fetch` 2.8 kB → `request` 7.5 kB → TLS | **+13.7 kB** |
| 0.5.1 | 35,572 B | 24,752 B: 同じ経路 (`jobs_task` の poll 2.4 kB は同じ。TLS の `client_finished` / `write_record` のフレームが +1.2 kB: この変更では触っていない関数。fat LTO のインライン化が変わったと推定)。流れる文字の組み立ては描画タスク (2.2 kB) の中で、文字列は static | **+10.8 kB** |
| 0.5.0 | 36,380 B | 23,588 B: 同じ経路 (`jobs_task` の poll 2.4 kB)。設定ページの経路 (`noinline(Server::serve)` → 設定の保存 → `TickerConfig::parse`) は ≈ 7.5 kB。待ち受けソケットのバッファ 2 kB を static に置いた分だけ空きが減った | **+12.8 kB** |

0.4.2 の注意 (試作で stack-report が見つけたもの): 回復モードを別のタスクにするとタスク領域 (OTA 確認の future ≈ 15 kB) が
2 つ分要ってスタックが 15 kB 減るので、取得タスクの中で動かす。取得を `with_timeout` でもう 1 段包むと、包んだ future を一旦スタックに
作ってから移すので取得タスクの poll が 30 kB になった (外した。内側の打ち切りで足りる)。大きな future は `noinline` で包み、
poll をインライン展開させない (`src/noinline.rs`)。

0.4.1 でしたこと:

- 取得 (OTA / NTP / 天気 / 文字) を main から別タスク `jobs_task` に分けた。main の poll のフレーム (接続管理なども
  含む 8〜14 kB) が TLS の経路に乗らない。
- 2 kB の `String<URL_MAX>` を値で返す / ローカルに置く箇所 (`latest_asset_url`、リダイレクトの `Location`) を無くした
  (main のフレーム 14.0 kB → 8.0 kB、`fetch_small` 4.8 kB → 2.8 kB)。
- スタックの上端を 0x2008_0000 → 0x2008_2000 (SRAM8/9 の 8 kB、pico-sdk の既定と同じ。`memory.x` の `_stack_start`)。
- 使われていないヒープ (embedded-tls の `rsa` のため) を 8 kB → 1 kB (呼び出しグラフで確保が起きないことを確認)。
- MSPLIM (ARMv8-M のスタック下限レジスタ) を `_stack_end` に設定。越えた瞬間に HardFault になり、`STACK OVERFLOW` を
  記録してリセットする (§8)。flip-link (スタックを RAM の最下位に置く) も検討したが、RP2350 では RAM の下
  (0x1FFF_xxxx) が XIP の窓で書き込みが確実に fault しないので、ハードウェアの MSPLIM にした (ツールの追加も不要)。
- CI (`build.yml`) が `scripts/stack-report.py out/ticker.elf` を実行し、最深経路が空きに収まらなければビルドを失敗させる
  (証明書検証の経路まで含めても 32.7 kB で収まる)。
- 起動時に空きスタックを模様で塗り、どこまで上書きされたかを 1 s ごとに数えて、状態行 2 に
  `stk 22.9/39.5K` (最大使用量 / 大きさ) と出す (defmt にも `stack high-water: N of M B`)。実機の実測値はこれで分かる。

## 8. OTA 到達保証 (0.4.2〜、`src/boot_policy.rs` / `src/supervisor.rs`)

**どんな壊れ方をした版が届いても、「ウォッチドッグで再起動 → 最新の版を確認 → 更新」までは必ず進む**ようにする仕組み。
0.4.0 は OTA の経路そのもの (最初の HTTPS) で固まり、自分では直せず USB で書き直すしかなかった (§8.6)。
0.4.2 は次の 3 段で守る。

1. **壊れた版は buy しない** (§8.2): OTA で届いた版は、OTA 確認と各機能の一巡を実際にやってみて 25 s 健全に動くまで
   buy しない。途中で落ちる / 止まる版は buy されず、bootrom が前の (動いていた) 版に戻す。
2. **buy の後で落ちるようになったら回復モード** (§8.3): 2 回続けて異常終了したら、Wi-Fi + OTA だけの最小構成で起動する。
3. **回復モードでも落ちるなら他方区画へ戻る** (§8.4): 前に buy した版を FLASH_UPDATE 起動する。

どの段でも、ウォッチドッグ (8 s) は **main の最初から** 動いている (§8.1)。

### 8.1 起動の流れ

```text
電源 / リセット
  └─ bootrom: A/B のうち buy 済みで版数の大きい方 (FLASH_UPDATE 起動なら対象の区画、TBYB でも可)
      └─ main: embassy_rp::init → ウォッチドッグ 8 s 開始 (TBYB 起動では bootrom の 16.7 s を縮めるだけ)
          ├─ 前回の記録 (SCRATCH5〜7) / 連続異常終了の回数 (SCRATCH1) / 他方区画から戻された印 (SCRATCH0) を読む
          ├─ boot_policy::decide ─┬─ 通常モード (TBYB の buy 待ちもここ)
          │                       ├─ 回復モード (通常で 2 回続けて異常終了)
          │                       └─ 他方区画へ (回復モードで 3 回続けて異常終了、1 回だけ)
          │
          ├─ 通常: LCD 準備 → SD (wifi.txt / ticker.txt、期限 5 s) → data 区画 (Wi-Fi の写し) → 走査開始 → 監視開始
          │         → USB → CYW43 → join + DHCP → ★OTA 確認 (最初の仕事) → NTP / 天気 / 文字 / 最初の写真
          │         → (TBYB なら) 25 s 健全 → explicit_buy → ウォッチドッグを動かし直す → 60 s ごとに OTA 確認
          ├─ 回復: 画面 (黒地に文字) → Wi-Fi の資格情報 (data 区画の写し、無ければ SD の wifi.txt だけ 4 s)
          │         → CYW43 → join + DHCP → ★OTA 確認 (60 s ごと) → 新しい版があれば入れて FLASH_UPDATE 起動
          │         → 無ければ 10 分後に通常モードを 1 回試す (落ちたらすぐ回復モードへ戻る)
          └─ 他方区画へ: SCRATCH0 に自分の版数を置き、画面も Wi-Fi も使わずに reboot(FLASH_UPDATE, 他方区画)
```

- **初期化中** (描画が始まるまで): main が各段階の前にウォッチドッグを明示的に再ロードする。SD の読み込みは期限付き
  (`sdcard::set_deadline`: 期限を過ぎると SPI の転送を失敗させる。カードが無いと embedded-sdmmc の再試行が
  ≈ 25 s 戻らなかった)。どこかで止まれば 8 s でリセット (記録は無いが「この版の記録 + 時間切れ」を異常終了と数える)。
- **描画が始まってから**: 0.4.1 と同じ生存確認 (main / 取得 / 描画タスク。LCD のフレーム割り込みが 0.5 s ごとに確かめ、
  揃っていれば再ロード、止まったタスクがあれば記録してすぐリセット)。TBYB の buy 待ちも同じ仕組みで再ロードする
  (0.4.1 までは延長タスクが無条件に延ばしていたので、buy 待ちで止まったタスクがあっても締め切りまで待っていた)。
- `explicit_buy` は bootrom がウォッチドッグを止める (CTRL.ENABLE = 0) ので、直後に動かし直す (`supervisor::rearm`)。
- どの取得も内側で打ち切る (NTP 5 s × 3 段 × 2 ホスト、天気 / 文字 20 s、manifest 30 s、ダウンロード 300 s)。
  OTA 確認は取得タスクの最優先なので、他の取得が詰まっても最長 ≈ 20 s しか遅れない。OTA 専用のタスクは作らない
  (TLS のバッファ ≈ 30 kB を 2 組置く RAM が無い)。

### 8.2 TBYB の buy 条件 (0.4.1 は Wi-Fi + DHCP だけだった)

buy 待ちの版は、次が **全部** 揃ってから 25 s (`BUY_SETTLE_MS`) 健全に動いたら buy する (`boot_policy::BuyGate`)。

| | 条件 | LCD の `wait:` |
|---|---|---|
| (a) | Wi-Fi に join して DHCP で IP を得た | `wifi` |
| (b) | OTA の manifest 確認が TLS + HTTP を最後まで通った (manifest.json を解釈できた、またはリダイレクトを追った後の 404 / 5xx などの確定したステータス。`boot_policy::classify_check`) | `ota` |
| (c) | NTP / 天気 / 文字 / SD の設定 / 最初の写真を 1 回ずつ試した (成否は問わない、落ちずに戻った)。0.5.0〜 設定ページのサーバが待ち受けを始めた | `sd` `web` `ntp` `weather` `message` `photo` |
| (d) | main / 取得 / 描画 (/ 設定ページの要求の処理中は web) の生存確認が揃っている (途中で Wi-Fi が落ちる / 途切れたら 25 s を数え直す) | `health` / `settle 12s` |

- 締め切りは起動から **180 s** (0.4.1 は 120 s)。過ぎたら buy せず、ウォッチドッグの再ロードをやめて 8 s 後に旧版へ戻る。
- buy 待ちの間の OTA 確認は **manifest を読むだけ** (新しい版があっても落とさない。書き込み先の他方区画は、buy されなかった
  ときの戻り先だから)。buy した直後にもう一度確認して、新しい版があればそこで落とす。
- ネットワーク / GitHub が使えないとき:

| 状況 | 結果 |
|---|---|
| join / DHCP が締め切りまで通らない | buy しない → 旧版へ戻る (旧版は動くので許容)。旧版は 10 分後に同じ版の FLASH_UPDATE 起動を再試行する |
| つながるが manifest の取得が DNS / TCP / TLS / 時間切れで失敗 | 締め切りまで **10 s ごと**に試し直す (`PENDING_OTA_RETRY_MS`) |
| TLS は通るが (リダイレクトを追った後の) HTTP 5xx / 404 | TLS + HTTP の経路は通っているので (b) を満たす |
| 応答は来るが使えない (ヘッダが 8 kB に収まらない、構文エラー、Location の不備、manifest が切れている / 解釈できない) | 証拠にならない (`CheckOutcome::Unproved`)。締め切りまで 10 s ごとに試し直し、通らなければ buy しない |

- 巻き戻った版の再試行は 0.2.4 からの 10 分ごと (`REJECTED_RETRY_DELAY`) のまま。壊れた版が届いた場合、旧版は 10 分に
  1 回それを試して戻る (1 回の試行は締め切り以内、早く落ちる版ほど早く戻る)。直した版が出れば次の確認 (60 s 以内) で
  そちらを入れる。

### 8.3 回復モード

**通常モードで 2 回続けて異常終了**したら (`boot_policy::RECOVERY_AFTER`)、次の起動は回復モードになる。

| 使うもの | 使わないもの |
|---|---|
| ウォッチドッグ + 生存確認、LCD (黒地に `FONT_6X10` の文字だけ)、CYW43 + join + DHCP、OTA の確認 / ダウンロード / 検証 / FLASH_UPDATE | SD (写真、ticker.txt、BMP の一覧)、NTP、天気、文字、写真の背景、AA 数字、東雲フォント、USB |

- 異常終了として数えるもの: panic / HardFault / スタック溢れ / タスクの停止 / 未登録の割り込み (どれも記録してリセット) と、
  **記録の無いウォッチドッグの時間切れ** (この版の記録が残っているのに時間切れで戻った = 割り込みごと止まった / 初期化中に止まった)。
  TBYB で試した **他の版** の記録 (巻き戻り) は数えない。
- Wi-Fi の資格情報は data 区画の写し (`src/persist.rs`、通常モードが wifi.txt を読めたときに内容が変わっていれば書く) を使い、
  SD には触れない。写しが無いとき (0.4.2 が一度も通常モードで起動できなかった) だけ、期限 4 s で `wifi.txt` だけを読む。
  写しはパスワードも平文 (SD の wifi.txt と同じ)。picotool で読み出せるので、消したいときは data 区画を消去する。
- OTA 確認は 60 s ごと (失敗しても 60 s。通常モードのバックオフ 10 分までは待たない)。新しい版があれば通常と同じく落として
  検証し、FLASH_UPDATE 起動する (TBYB で §8.2 の条件を満たせば buy)。
- 確認が通って新しい版が無ければ、**10 分後に通常モードを 1 回試す** (一時的な故障なら元に戻る。回数を「あと 1 回で回復モード」
  にしておくので、落ちればすぐ回復モードに戻る)。Wi-Fi の資格情報が無いなど OTA ができないときも、10 分後に通常モードを試す。
- 回数は「通常モードで OTA 確認が通ってから 10 分異常なく動いた」ときに 0 に戻る (0.4.1 は起動から 10 分)。電源の入れ直しでも 0。

画面 (`src/ui/recovery.rs`、シミュレータ `tools/ui-sim/scenarios/recovery.json`):

```text
RECOVERY MODE                                         ticker v0.4.2 slot B   ← 赤い帯
last reset: panic src/ticker/slideshow.rs:231 @42s #2                         ← 赤: 前回の理由と連続回数
crashed 2x in normal mode -> Wi-Fi + OTA only (rec #0)                        ← 黄
Wi-Fi: aterm-abff4a-g 192.168.200.130                                         ← 緑 / 黄 / 赤
OTA: up to date (latest 0.4.2), next check in 42s                             ← wifi_ota と同じ OTA 行
no newer release: retry normal mode in 9:18                                   ← 次にすること
Wi-Fi credentials: flash copy (SD not used)
NORMAL P1 A:0021 consid B:4C4D launched reset:force                           ← 起動種別 / リセット理由
fix: publish a newer release (checked every 60 s) or USB
```

### 8.4 他方区画へ戻る

回復モードでも **3 回続けて異常終了**したら (`FALLBACK_AFTER`)、画面も Wi-Fi も使わずに、SCRATCH0 に自分の版数を置いて
**他方区画を `reboot(FLASH_UPDATE)` で起動する** (`ab_boot::reboot_flash_update`、OTA の再起動と同じ API)。

- bootrom (pico-bootrom-rp2350 の `varm_flash_boot.c` / `varm_launch_image.c`) は、FLASH_UPDATE の対象区画に正しいイメージが
  あれば **版数によらず** それを選ぶ。対象の方が版数が小さく、TBYB でない (前に buy された) イメージなら、起動時に
  **他方 (落ち続けた版) の区画の先頭セクタを消す** (版数の巻き戻し)。つまり「1 回だけの起動」ではなく、以後はその版だけが起動する。
- 戻った先の版 (0.4.2 以降) は SCRATCH0 の印を読み、状態行 1 に 5 分間赤で `FALLBACK: v0.4.3 kept crashing, back on v0.4.2 (blocked)`
  と出し、その版を data 区画に **入れない版** として記録する。以後 OTA はその版以下を入れない
  (`OTA: latest 0.4.3 blocked (fell back from it), waiting`)。直した版 (より新しい版数) が出れば入れる。
- 行き来の防止: 他方区画へ戻すのは 1 回だけ (`BootState::fell_back`)。他方区画に起動できるイメージが無く同じ版がまた起動したら
  (印が自分の版数)、以後は回復モードのまま (`fallback to the other slot failed ...`)。入れない版の記録は電源を切っても残る。
- 他方区画に buy されていない新しい版 (巻き戻った TBYB の版) があれば、それが TBYB で試される (条件を満たせば buy、だめなら戻る)。

### 8.5 限界 (正直なところ)

- **両方の区画が壊れている** (他方区画も、回復モードの OTA も通らない) 場合は、USB (BOOTSEL + UF2 の D&D、`ticker.uf2`) でしか直せない。
- 戻り先が **0.4.1** のとき (0.4.2 が初めての版なので、0.4.2 自体が buy 後に落ち続けた場合): 0.4.1 は印も入れない版も知らないので、
  0.4.2 をもう一度落として試す (10 分おき)。0.4.2 は §8.2 の条件で再び buy され、また落ちて戻る、を繰り返しうる。どの周回でも
  OTA 確認までは進むので、直した版 (0.4.3) を出せば入れ替わる。
- 他方区画に巻き戻った TBYB の版が残っていると、印 (SCRATCH0) はその版の起動で消えるので、戻したことを覚えていられない
  (落ちる版とその TBYB 版の間を行き来しうる。どの周回でも OTA 確認はする)。
- buy 待ちでは ダウンロード → 書き込み の経路 (manifest の後) は試せない (試すと戻り先の区画を壊すため)。この経路は各版で共通の
  コード (`ota::app::run_ota_check`) で、0.2.6 から実機で動いている。
- 異常終了の回数は SCRATCH (電源断で消える) にあるので、電源を入れ直すと 0 から数え直す。
- 試験用に落とす手段: `ticker.txt` に `debug_crash=boot` / `ota` / `slideshow` (§4)。buy 済みの版の通常起動でだけ効く。

### 8.6 0.4.0 / 0.4.1 の経緯

0.4.0 は、OTA で入った直後の 1 分ほどで画面が固まった (時計が止まり、状態 3 行のまま。2026-09-30 の写真)。
原因は §7.1 のスタック溢れ: 接続 → buy → NTP の直後、最初の HTTPS (天気) の TLS ハンドシェイクで ≈7 kB 溢れ、
.bss の最上位にある `FRAME_WAKER` (LCD のフレーム割り込みが毎フレーム起こす waker) や USB の waker を壊した。
次のフレーム割り込みが壊れた waker を呼んで HardFault になり、当時の HardFault ハンドラは `loop {}` だった。
buy の後は bootrom のウォッチドッグも止まっているので、そのまま何時間も止まっていた。0.4.0 の buy 条件は Wi-Fi + DHCP だけで、
OTA 確認 (同じ TLS の経路) より前に buy していたので、自分の OTA でも直せなかった。0.4.1 は「止まったら記録して自分で戻る」
ようにした (下の表示。0.4.2 でもそのまま):

| 表示 | 意味 |
|---|---|
| `last reset: panic src/ui/slide.rs:123 @61s` | panic (ファイル:行、@ は起動からの秒)。依存クレートなら `embedded-tls-0.18.0/connection.rs:77` の形 |
| `last reset: HardFault pc=1000abcd lr=10001235 @12s` | HardFault。PC を `llvm-addr2line -e ticker.elf 0x1000abcd` で引く |
| `last reset: STACK OVERFLOW pc=... @2s` | MSPLIM を越えた (§7.1) |
| `last reset: wdt: render stalled 5s @300s` | 描画タスクが 5 s 以上止まった (`main` / `jobs` も同様、90 s) |
| `last reset: wdt timeout (no record, cyw43-init) @3s` | 割り込みも止まった / 初期化中に止まったので記録できず、ウォッチドッグの時間切れで戻った (括弧内は最後の段階) |
| 末尾の `#2` | 2 回続けて異常終了した (次は回復モード) |

- 記録の置き場所: SCRATCH5〜7 は TBYB の記録 ([wifi-ota.md §5.2](wifi-ota.md)) と同じ形 (段階 `Running` / `recovery` / `ota-ok` /
  `fallback` / `sd-init` と異常終了の段階 0xE0〜0xE6)、SCRATCH0 に付加情報 (panic の `&Location`、HardFault の LR、
  監視中の印、他方区画へ戻す印)、SCRATCH1 に `boot_policy::BootState`。bootrom は SCRATCH0/1 に書かない。
  picotool の USB reset interface でリセットするときは記録を消す。
- buy 待ち中 (TBYB) の panic / HardFault / 停止もすぐリセットするので、締め切りを待たずに旧版へ戻る (旧版が `TBYB x.y.z: PANIC ...` と出す)。

### 8.7 ホストでの確認 (`tools/ticker-tests`)

`boot_policy` の判定 (回数の数え方、回復 / 他方区画、buy 条件、data 区画の記録) の単体テストに加えて、`boot_sim.rs` が
起動の流れを模擬する: bootrom の A/B / TBYB / FLASH_UPDATE / 版数の巻き戻しの選び方、SCRATCH の残り方、各段階の所要時間と
ウォッチドッグ、OTA (60 s ごと、10 分後の再試行)、回復モードを模型にし、**本物の `boot_policy` で** 動かす。

| 注入した故障 | 確かめたこと |
|---|---|
| 新しい版が LCD / SD / CYW43 / join / DHCP / OTA の TLS / NTP / 天気 / 文字 / 写真 の各段階で落ちる・止まる (20 通り) | buy しない、旧版へ戻る、再試行は 10 分ごと (1 時間で 5 回)、OTA 確認の間隔は最大 172 s、直した版で直る |
| buy の後 30 s / 5 分 / 20 分で落ちる | 回復モードに入る (20 分は 10 分で回数が戻るので入らない)、OTA 確認の間隔は最大 94 s、直した版が 61 分に動く |
| 回復モードでも落ちる (CYW43 / 画面 / OTA / 30 s 後) | 3 回で他方区画へ戻る、戻った版は落ちた版を入れ直さない、直した版で直る |
| buy 待ちの間 Wi-Fi が無い / GitHub に届かない | buy せず戻り、後で buy する |
| GitHub が 5xx | buy する (経路は通っている) |
| GitHub の応答が使えない (ヘッダの溢れ / 構文エラー / 切れた manifest) | 証拠にならないので buy しない。応答が直ってからの再試行で buy |
| 他方区画が空のまま落ち続ける | 他方区画へは 1 回だけ、以後は回復モードで OTA 確認を続け、新しい版で直る |
| 途中で電源を入れ直す | 直した版にたどり着く |
| 両方の区画が壊れていて回復モードも落ちる | OTA 確認に届かない (§8.5 の限界) ことを確認 |

## 9. 既知の制限

- TLS はサーバ証明書を検証しない (`TlsVerify::None`、wifi_ota と同じ。[wifi-ota.md §6](wifi-ota.md))。
  天気 / 文字も同様なので、経路上で内容を書き換えられる (表示が変わるだけで、ファームウェアの検証は別)。
- 時計は SNTP 同期 (6 時間ごと) の間 RP2350 の内蔵クロックで進む (数 ppm〜数十 ppm、6 時間で最大 1 秒程度)。
  うるう秒・夏時間は扱わない。
- Open-Meteo の応答が 1,536 B を超える (項目を増やした) 場合は `too long`。無料枠 (1 日 10,000 / IP) を
  超えると `HTTP 429`。
- 流れる文字は 512 バイトまで、1 行のみ。色や複数行の指定は無い (設定の部分の色分けは端末が決める、§1.3)。
- 流れる文字の設定 URL とコード (0.5.1〜) は Glass の帯 (264 px) に一度に全部は入らない (見出しからコードまで ≈ 294 px)。
  流れながら読む。Dock / Classic (≈ 380 px) なら一度に見える。
- 設定ページ (0.5.0〜) の制限 (平文の HTTP、接続 1 本ずつ、RSSI と mDNS は無し、OTA / 取得の間は応答しない) は
  [settings-server.md §4 / §7](settings-server.md)。
- 天気の地名 (`place`) と文字は東雲フォントにある文字だけ (JIS X 0208 第一・第二水準 + JIS X 0201。絵文字は `□`)。
- ウィジェットの配置は 3 種類から選ぶだけ (400×96 前提)。
- 背景の写真は SD のルートだけ (サブディレクトリは見ない)、8.3 名、最大 16 枚、非圧縮 24 / 32 bit BMP のみ。
  大きな BMP は読み込みに時間がかかる (400×96 ならおよそ 1〜2 s、1920×1080 の BMP は数十秒)。
- 切り替えの途中で読めなかった写真は元に戻せないのでグラデーションになる (次の間隔で次の写真へ)。
- 実機確認: v0.3.0 は 0.2.8 からの OTA で実機に載り、NTP / 天気 / 文字の取得と表示を確認した (2026-09-29)。
  v0.3.1 のフォントは実機の写真で確認済み (「きれいに見えた」)。v0.4.0 は写真の背景とガラスの画面が表示されたが、
  最初の HTTPS で固まった (§8.6)。v0.4.1 は USB で書き直した後、時計 / 天気 / 写真 / 文字と状態表示 `v0.4.1` が動くことを
  実機の写真で確認した (2026-09-30)。**v0.4.2 の OTA 到達保証 (buy 条件、main の最初からのウォッチドッグ、回復モード、
  他方区画へ戻る、data 区画の写し、SD の期限) は実機で未確認** (判定はホストのテストと起動の流れの模擬で確認、§8.7)。
  以下は v0.4.1 までの注記:
  (スタックは逆アセンブルからの見積もり、生存確認の判定と表示の文字列はホストのテストで確認)。

## 10. 履歴

| 版 | 内容 |
|---|---|
| 0.6.4 | 電力値を枠内で右寄せし、グラフの数値・時計の高さと行間を調整。グラフを左の136pxの枠に収め、中央の背景を広く見せる。時計・日付・天気の枠は最も広い表示行に合わせて自動で幅を変え、気温の右に降水確率を表示。設定ページの狭い画面・写真操作・ダイアログ・保存帯の配置を修正し、LCDとWebの配置検証を追加 |
| 0.6.3 | 電力表示の通常 / 大きく / 大きく＋グラフと、1分・5分・30分・1時間・6時間・24時間の期間選択を追加。設定ページと SD の設定に対応。固定 RAM の履歴は起動中に蓄積し、欠測区間を線でつながない。180度回転・下部の状態表示条件は維持 |
| 0.6.2 | デバイスを逆さに置くための画面全体の180度回転を追加。設定ページの「画面の向き」または SD の `rotate=180` で時計・天気・電力・流れる文字・背景をまとめて回転する。既定は `rotate=0`。回復モードは SD を読まず通常の向きで表示する |
| 0.6.1 | fnc765 側への多機能 ticker と OTA 基盤の統合。P110M の Matter 消費電力表示、文字に合わせた電力欄の幅・中央揃え・背景統一、DMA のフレーム通知修正による通常表示 60 FPS。開発版 0.6.0 より新しい版として OTA 配布する。状態表示の切り替え条件は従来のまま ([matter-power.md](matter-power.md)) |
| 0.3.0 | 初版。`wifi_ota` の OTA / TBYB を `ota::app` に共通化し、NTP 時計 + Open-Meteo 天気 + `message.txt` の流れる文字 + 美咲フォントを追加。Release の OTA イメージを `ticker.bin` に切り替え |
| 0.3.1 | 日本語フォントを美咲 8×8 の 2 倍表示から東雲 14 ドットの等倍に変更 (実機で線が太く潰れて見えたため。§5)。流れる文字の下の区切り線が状態行 1 の文字に重なっていたのを直し、状態行を 9 px ピッチ (y 68 / 77 / 86) に、時計・日付・天気を 1 px 上に |
| 0.4.0 | **写真の背景 + モダンな画面**。SD の BMP のスライドショー (§1.2、`slide` / `images` / `sdfast`)、ガラスの板・AA 数字の時計・天気アイコン・降水確率の錠剤 (§1、`layout`)、状態 3 行を必要なときだけ出す (§1.1、`status`)。描画を `src/ui/` に分けて PC のシミュレータ `tools/ui-sim` と共用 ([ui-sim.md](ui-sim.md))。バックバッファを RGB565 にして背景用の RAM を作った (§7) |
| 0.4.1 | **固まる不具合の修正と自動復帰** (§7.1、§8)。0.4.0 は最初の HTTPS (天気) の TLS ハンドシェイクでスタックが溢れて固まっていた (ticker.txt とは無関係。無くても既定値で動く、§4)。取得を別タスクに分け、2 kB の URL の一時領域を無くし、スタックを SRAM8/9 まで伸ばし、使わないヒープを減らして、空き 27.4 kB → 39.5 kB、最深経路 35.1 kB → 24.9 kB。MSPLIM でスタック溢れを検出。buy の後もウォッチドッグ (8 s) を動かし、main / 取得 / 描画の生存確認が揃うときだけ再ロード。panic / HardFault / 停止は記録してリセットし、次の起動が `last reset: ...` と出す。接続後の最初の仕事を OTA 確認にし、写真の読み込みもその後。3 回続けて異常終了したら安全モード。状態行 2 にスタックの最大使用量 `stk` |
| 0.4.2 | **OTA 到達保証** (§8): 壊れた版が届いても「ウォッチドッグで再起動 → 最新の版を確認 → 更新」まで必ず進む。(1) TBYB の buy 条件を Wi-Fi + DHCP + OTA の manifest 確認 (TLS + HTTP) + NTP / 天気 / 文字 / SD / 最初の写真の一巡 + 25 s の健全な稼働に強化 (締め切り 180 s、buy 待ちの OTA は manifest だけ)。(2) ウォッチドッグ (8 s) を main の最初から、どの起動でも。buy 待ちも生存確認つきで再ロード。SD の読み込みに期限 (カード無しで 25 s 止まっていた)。(3) 安全モードを **回復モード** に置き換え: 2 回続けて異常終了したら SD を使わず Wi-Fi + OTA だけ (資格情報は data 区画の写し)、60 s ごとに OTA、10 分後に通常モードを再試行。(4) 回復モードでも 3 回落ちたら他方区画を FLASH_UPDATE 起動し、戻った版はその版を入れない。(5) 試験用 `debug_crash=`。(6) ホストで起動の流れを模擬するテスト (`boot_sim`)。CI の build ジョブで実行し、Release もこれとスタックの検査に通った版だけ |
| 0.5.0 | **設定ページ** ([settings-server.md](settings-server.md)): 同じ LAN のブラウザから地域 (都市の検索つき) / 表示 / 流れる文字 / 写真 (一覧、並べ替え、削除、400×96 に切り抜いて追加) を変え、SD の `ticker.txt` に書いてその場で反映する。アクセスコード (起動ごと、LCD に表示) + Host / Origin の確認 + 締め出し。サーバは取得タスクの中で OTA 確認の後に 1 要求ずつ動き、最初の OTA 確認が通ってから待ち受ける (回復モードでは動かない)。buy 条件の一巡に `web`、生存確認 `Who::Web` (20 s)。`ticker.txt` の `message=` (この端末で決める流れる文字)、上限 512 → 1,536 バイト。SD に書き込めるようにした |
| 0.5.1 | **設定 URL とコードを流れる文字に** (§1.3): 1 分だけ出ていた下の帯の案内をやめ、流れる文字の後ろに毎周 `◆ 設定 http://… コード … ◆` を入れる (URL とコードは水色、◆ は橙)。設定の部分があるときは文字列を切れ目なく繰り返して流す。IP / コードが変わればすぐ組み直し、IP が無い間は `設定: Wi-Fi 接続待ち`。待ち受け前と回復モードでは入れない。`ticker.txt` の `show_settings=0` (設定ページの切り替え) で入れない。「LCD にコードを表示」は設定の部分へ進めて 12 s 目立たせ、1 分は `show_settings=0` でも入れる。組み立ては `src/ui/scroll.rs` (static な共有モデルの中、ホストのテスト `scroll_tests` と ui-sim が同じコード) |
