fnc765/aki300yenLCD-raspico2w/hardware/review/design-rule-refinement-2026-09-17/routing-3d.png

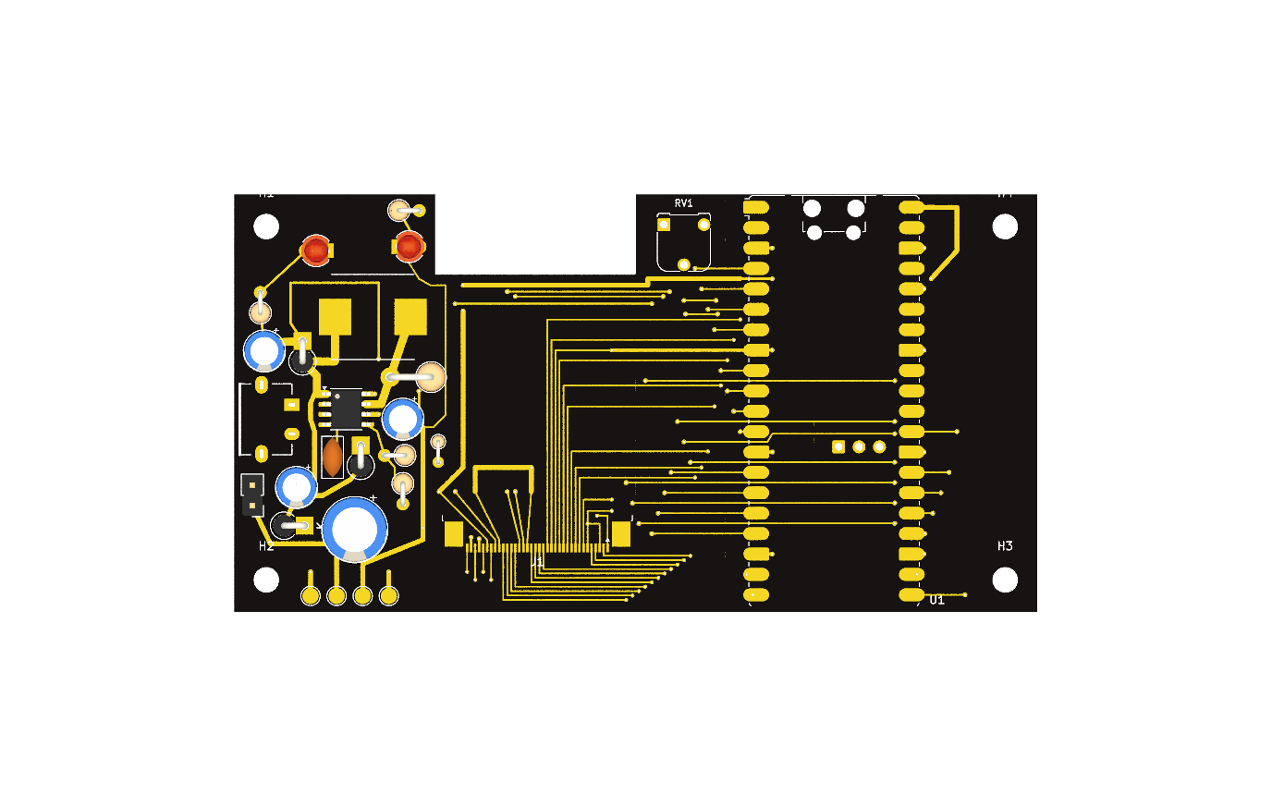
hardware/review/design-rule-refinement-2026-09-17/routing-3d.png
