fnc765/aki300yenLCD-raspico2w/hardware/review/ground-power-refinement-2026-09-17/bottom-3d.png

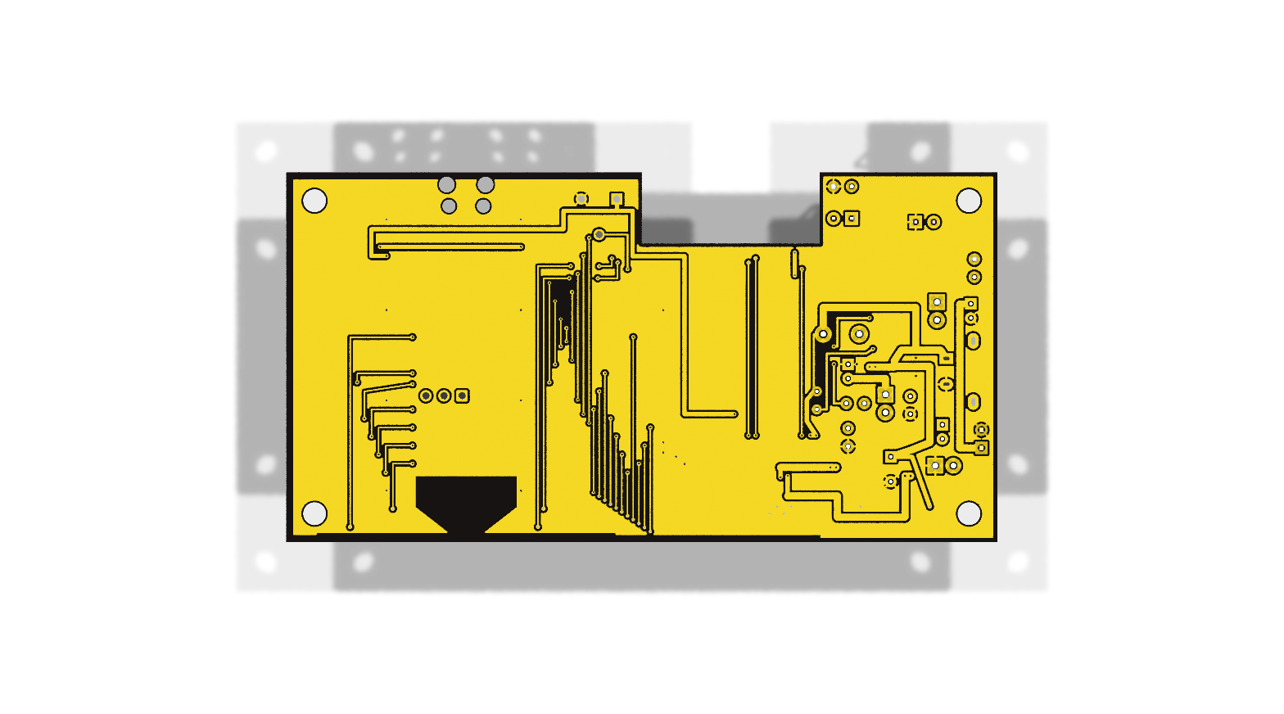
hardware/review/ground-power-refinement-2026-09-17/bottom-3d.png
