fnc765/aki300yenLCD-raspico2w/hardware/review/ground-power-refinement-2026-09-17/top-3d.png

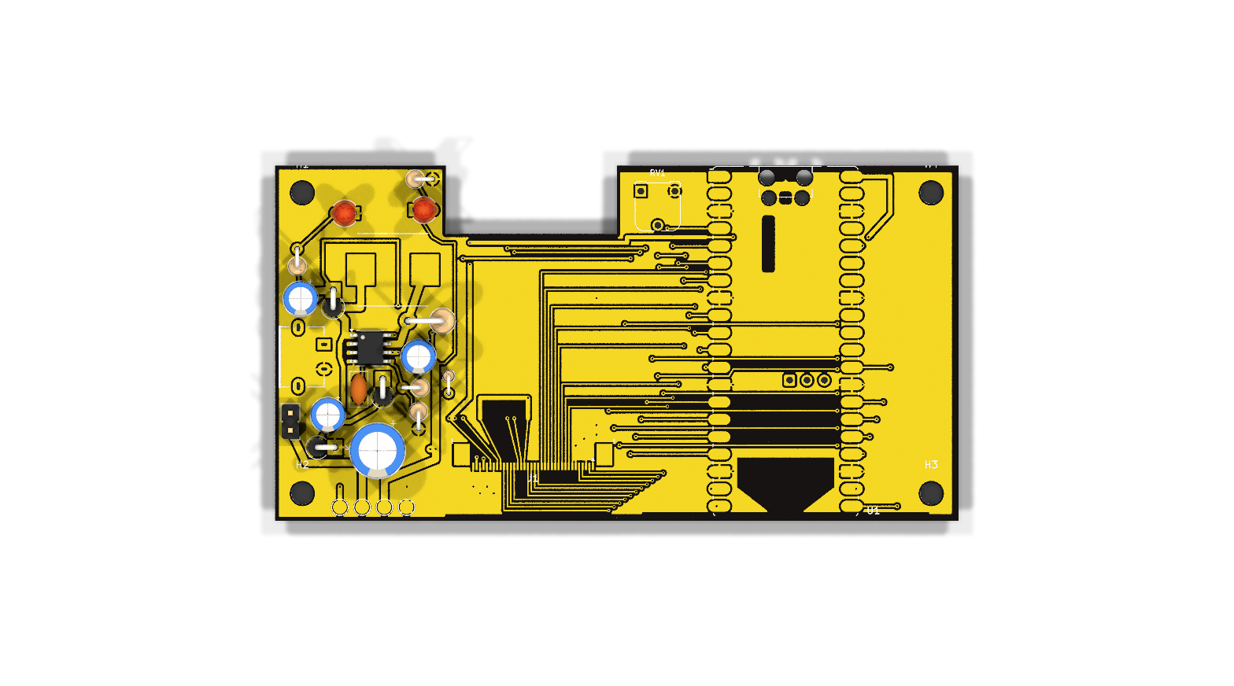
hardware/review/ground-power-refinement-2026-09-17/top-3d.png
