fnc765/aki300yenLCD-raspico2w/hardware/review/pico-lcd-routing-2026-09-17/routing-3d.png

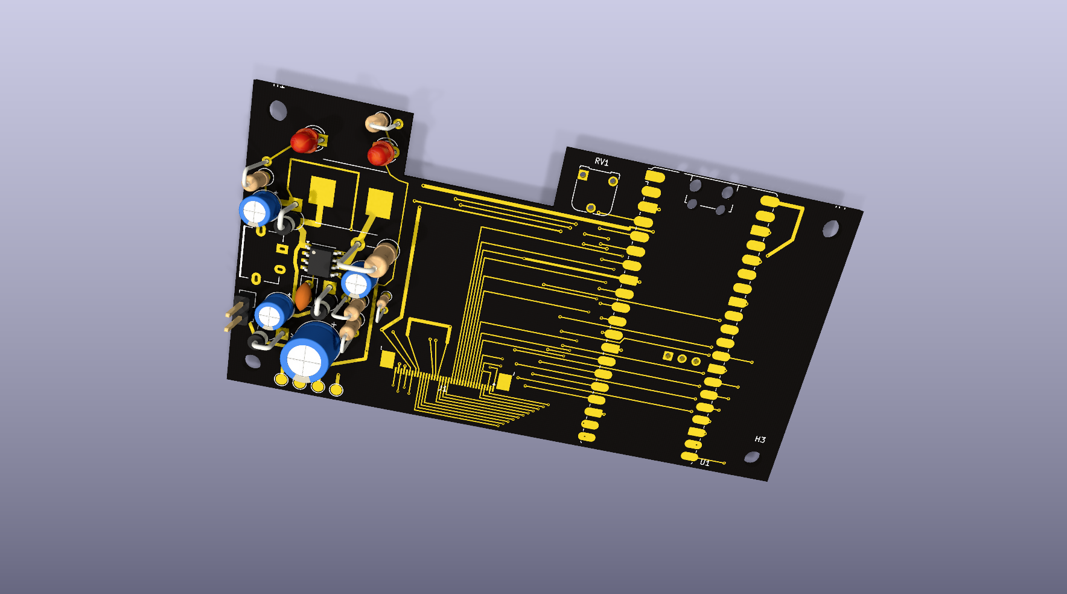
hardware/review/pico-lcd-routing-2026-09-17/routing-3d.png
