fnc765/aki300yenLCD-raspico2w/hardware/review/red-zone-placement-2026-09-16/placement.png

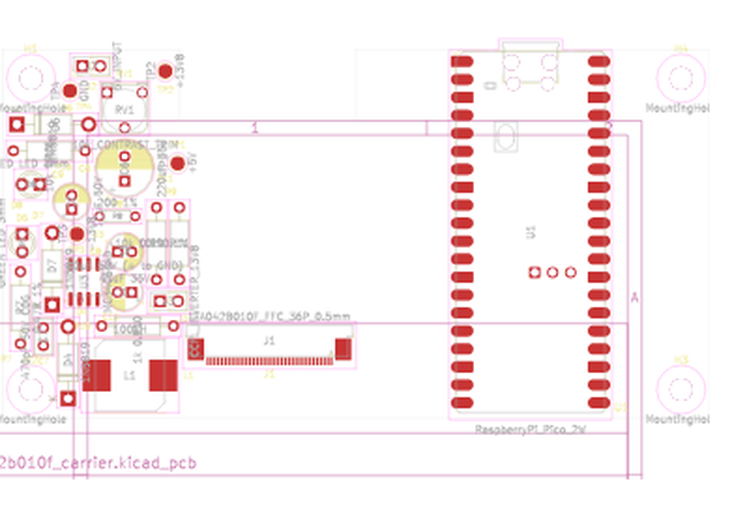
hardware/review/red-zone-placement-2026-09-16/placement.png
