fnc765/aki300yenLCD-raspico2w/review/silkscreen-review-2026-09-17/top-silkscreen-copper.png

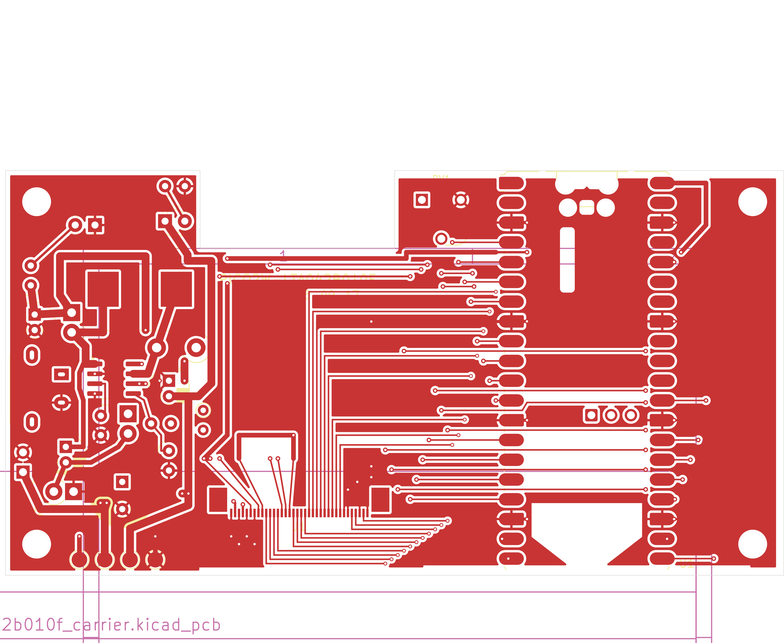
review/silkscreen-review-2026-09-17/top-silkscreen-copper.png
