fnc765/aki300yenLCD-raspico2w/pico_lta042b010f_carrier.kicad_pcb

## KiCad design pico_lta042b010f_carrier.kicad_pcb (2026-09-17)

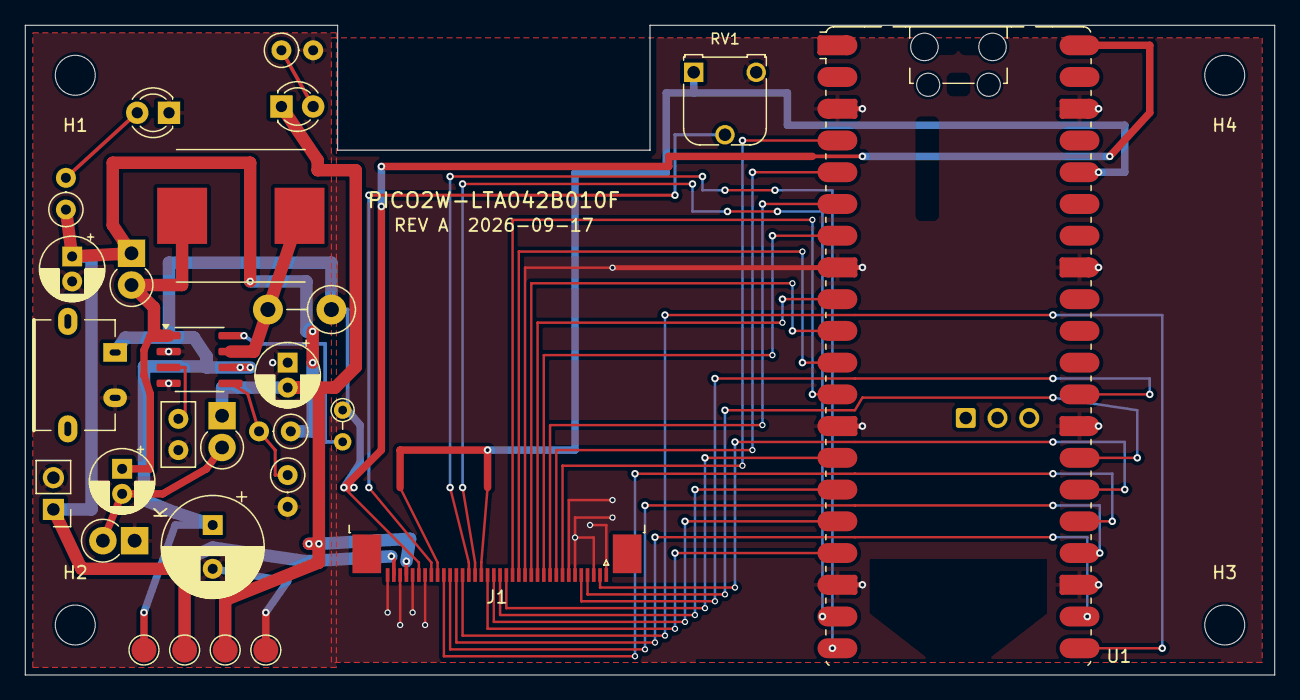
[picture p10: board pico_lta042b010f_carrier.kicad_pcb from above]

Board: 2 copper layers, 100.0 x 52.0 mm, 31 parts (0 on the bottom side), 35 nets.

Parts:
C6: 220uF 35V; CP_Radial_D8.0mm_P3.50mm
C7: 470pF 50V C0G; C_Disc_D5.0mm_W2.5mm_P2.50mm
C8: 47uF 35V; CP_Radial_D5.0mm_P2.00mm
C9: 10uF 50V; CP_Radial_D5.0mm_P2.00mm
C11: 10uF 50V (+ to GND); CP_Radial_D5.0mm_P2.00mm
D4, D6, D7: 1N5819; D_DO-41_SOD81_P2.54mm_Vertical_KathodeUp
D5: GREEN LED 3mm; LED_D3.0mm
D8: RED LED 3mm; LED_D3.0mm
H1, H2, H3, H4: MountingHole; MountingHole_3.2mm_M3
J1: LTA042B010F_FFC_36P_0.5mm; TE_3-1734839-6_1x36-1MP_P0.5mm_Horizontal
J2: USB-C 5V INPUT; A295_CTRPB_1
J3: CCFL_INVERTER_13V8; PinHeader_1x02_P2.54mm_Vertical
L1: 100uH; L_Taiyo-Yuden_NR-10050_9.8x10.0mm_HandSoldering
R7: 0.47R 1%; R_Axial_DIN0411_L9.9mm_D3.6mm_P5.08mm_Vertical
R8: 200 1%; R_Axial_DIN0204_L3.6mm_D1.6mm_P2.54mm_Vertical
R9, R11, R16: 10k 0.1%; R_Axial_DIN0207_L6.3mm_D2.5mm_P2.54mm_Vertical
R10: 1k 0.1%; R_Axial_DIN0207_L6.3mm_D2.5mm_P2.54mm_Vertical
RV1: 10k_CONTRAST_TRIM; Potentiometer_Runtron_RM-065_Vertical
TP1: +5V; TestPoint_Pad_D2.0mm
TP2: +13V8; TestPoint_Pad_D2.0mm
TP3: -13V8; TestPoint_Pad_D2.0mm
TP4: GND; TestPoint_Pad_D2.0mm
U1: RaspberryPi_Pico_2W; RaspberryPi_Pico_W_SMD_HandSolder
U3: MC34063AD; SOIC-8_3.9x4.9mm_P1.27mm

Connections:
+3V3: J1.21 (DVDD), J1.28 (AVDD), RV1.1 (HIGH), U1.36 (3V3_OUT)
+5V: C6.1 (+), J1.31 (GVDD), J2.1 (VBUS), R7.1, R8.1, TP1.1 (+5V), U1.40 (VBUS), U3.6 (VCC)
+13V8: C8.1 (+), D4.1 (K), J1.35 (VGON), J3.1 (+13V8), R9.1, R11.1, TP2.1 (+13V8)
-13V8: C11.2 (-), D7.1 (K), D8.1, J1.33 (VSS), TP3.1 (-13V8)
CPUMP_MID: C9.2 (-), D6.2 (A), D7.2 (A)
DRIVER_DC: R8.2, U3.8 (DC)
GND: C6.2 (-), C7.2, C8.2 (-), C11.1 (+), D5.1, D6.1 (K), J1.1 (TEST_FIXED_LOW), J1.3 (GND), J1.6 (UNKNOWN_FIXED_LOW), J1.7 (GND), J1.14 (GND), J1.30 (GND), J1.32 (GND), J1.34 (GND), J1.36 (GND), J2.2 (GND), J3.2 (GND), R10.2, R16.2, RV1.3 (LOW), TP4.1 (GND), U1.3 (GND), U1.8 (GND), U1.13 (GND), U1.18 (GND), U1.23 (GND), U1.28 (GND), U1.33 (GND), U1.38 (GND), U3.2 (SWE), U3.4 (GND)
IPK_SENSE: L1.1, R7.2, U3.7 (Ipk)
LCD_B0: J1.13 (B0), U1.10 (GP7)
LCD_B1: J1.12 (B1), U1.9 (GP6)
LCD_B2: J1.11 (B2), U1.7 (GP5)
LCD_B3: J1.10 (B3), U1.6 (GP4)
LCD_B4: J1.9 (B4), U1.5 (GP3)
LCD_B5: J1.8 (B5), U1.4 (GP2)
LCD_G0: J1.20 (G0), U1.17 (GP13)
LCD_G1: J1.19 (G1), U1.16 (GP12)
LCD_G2: J1.18 (G2), U1.15 (GP11)
LCD_G3: J1.17 (G3), U1.14 (GP10)
LCD_G4: J1.16 (G4), U1.12 (GP9)
LCD_G5: J1.15 (G5), U1.11 (GP8)
LCD_HSYNC: J1.4 (HSYNC), U1.27 (GP21)
LCD_NCLK: J1.2 (NCLK), U1.26 (GP20)
LCD_R0: J1.27 (R0), U1.25 (GP19)
LCD_R1: J1.26 (R1), U1.24 (GP18)
LCD_R2: J1.25 (R2), U1.22 (GP17)
LCD_R3: J1.24 (R3), U1.21 (GP16)
LCD_R4: J1.23 (R4), U1.20 (GP15)
LCD_R5: J1.22 (R5), U1.19 (GP14)
LCD_VSYNC: J1.5 (VSYNC), U1.29 (GP22)
NEG_LED_N: D8.2, R16.1
PWR_LED_P: D5.2, R11.2
SW_NODE: C9.1 (+), D4.2 (A), L1.2, U3.1 (SWC)
TC_TIMING: C7.1, U3.3 (TC)
VCPP_ADJ: J1.29 (VCPP_ADJ), RV1.2 (WIPER)
VFB: R9.2, R10.1, U3.5 (VFB)
