fnc765/aki300yenLCD-raspico2w/build.rs

use std::env;
use std::fs::File;
use std::io::Write;
use std::path::PathBuf;

fn main() {
    let out = &PathBuf::from(env::var_os("OUT_DIR").unwrap());
    File::create(out.join("memory.x"))
        .unwrap()
        .write_all(include_bytes!("memory.x"))
        .unwrap();
    println!("cargo:rustc-link-search={}", out.display());
    println!("cargo:rerun-if-changed=memory.x");

    println!("cargo:rustc-link-arg-bins=--nmagic");
    println!("cargo:rustc-link-arg-bins=-Tlink.x");
    println!("cargo:rustc-link-arg-bins=-Tdefmt.x");

    // 設定ページ (0.5.0〜、docs/settings-server.md): web/settings/index.html を gzip にして埋め込む
    // (src/web/server.rs が `Content-Encoding: gzip` でそのまま送る)
    let page = std::fs::read("web/settings/index.html").unwrap();
    File::create(out.join("settings.html.gz")).unwrap().write_all(&gzip(&page)).unwrap();
    println!("cargo:rerun-if-changed=web/settings/index.html");
    // Explicit local provisioning only. CI and normal builds contain no keys.
    println!("cargo:rerun-if-env-changed=TICKER_PROVISION_DIR");
    let mut provision = File::create(out.join("provision.rs")).unwrap();
    for (name, filename, max) in [("WIFI", "WIFI.TXT", 256), ("MATTER", "MATTER.TXT", 256)] {
        let bytes = if let Some(dir) = env::var_os("TICKER_PROVISION_DIR") {
            let path = PathBuf::from(dir).join(filename);
            println!("cargo:rerun-if-changed={}", path.display());
            let bytes = std::fs::read(path).expect("local provision file missing");
            assert!(bytes.len() <= max, "local provision file too large");
            bytes
        } else { Vec::new() };
        writeln!(provision, "pub const {name}: &[u8] = &{bytes:?};").unwrap();
    }
}

/// gzip (RFC 1952): 10 バイトのヘッダ + deflate + CRC-32 + 元の長さ
fn gzip(data: &[u8]) -> Vec<u8> {
    let mut out = vec![0x1f, 0x8b, 8, 0, 0, 0, 0, 0, 2, 0xff];
    out.extend(miniz_oxide::deflate::compress_to_vec(data, 10));
    out.extend(crc32(data).to_le_bytes());
    out.extend((data.len() as u32).to_le_bytes());
    out
}

fn crc32(data: &[u8]) -> u32 {
    let mut crc = !0u32;
    for &b in data {
        crc ^= u32::from(b);
        for _ in 0..8 {
            crc = if crc & 1 != 0 { (crc >> 1) ^ 0xEDB8_8320 } else { crc >> 1 };
        }
    }
    !crc
}
