fnc765/aki300yenLCD-raspico2w/src/lib.rs

//! Pico 2W + 300円LCD (LTA042B010F) ドライバ ライブラリ
//!
//! PIO を使用して 400x96 RGB666 TFT LCD を駆動する。
//! examples から定数やモジュールを参照するためにライブラリクレートとして公開。

#![no_std]

pub mod ab_boot;
pub mod boot_policy;
pub mod boot_trace;
pub mod font;
pub mod heap;
pub mod image_def;
pub mod lcd;
pub mod matter;
pub mod noinline;
pub mod ota;
pub mod persist;
pub mod provision;
pub mod pins;
pub mod sdcard;
pub mod supervisor;
pub mod ticker;
pub mod ui;
pub mod usb_reset;
pub mod web;
pub mod wifi;
