fnc765/aki300yenLCD-raspico2w/(commit log)

2026-02-10 feat: Layer 2まで実装
2026-02-10 feat: layer3まで実装
2026-02-11 feat: Layer 4 DMA カラーバー実装 + Layer 3 オフセット修正
    - src/bin/layer4_dma_colorbar.rs: DMA スキャンライン転送カラーバーテスト新規作成
    - SM0: DMA dma_push() でピクセル自動転送 (CPU負荷ゼロ)
    - SM1: CPU wait_push() で225 words/frameタイミング供給
    - SMPTE 8色カラーバーパターン表示
    - NCLK停止リスク実質解消 (FIFO 2.3μs > CPU 0.3-0.7μs)
    - src/bin/layer3_solid_color.rs: プレフィルオフセット補正
    - VSYNC ライン供給: 512→504ワード (プレフィル8+504=512)
    - SM0_FIFO_DEPTH 定数化、frame_count wrapping_add
    - docs/setup-guide.md: ビルド環境構築ガイド新規作成 + layer4タ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
2026-02-11 fix: Layer 1 ピン方向(Output)設定の欠落を修正
    - set_pin_dirs(Direction::Out) が未設定のため GP20 に信号が出力されなかった
    - Direction の import 追加
    - Layer 2-4 では正しく設定済みだった
2026-02-11 fix: Layer 2 FIFO overflow + 位相ずれバグ修正
    - FifoJoin::TxOnly 追加 (TX FIFO 4→8エントリ)
    - CPU ループの位相をプレフィルと整合するよう修正
    - frame_count wrapping_add に変更
2026-02-11 fix: Layer 3/4 SM1 CPU ループ位相ずれバグ修正
    - SM1 ループを 0..V_NORMAL_LINES(111) → 1..V_NORMAL_LINES(110) に修正
    - 通常ライン#1 は SM0 ピクセルのみ供給 (SM1 はプレフィル/前ループ末尾で供給済み)
    - フレーム末尾に次フレーム通常ライン#1の SM1 データ (2値) を追加
    - SM1 値数: 220 + 3 + 2 = 225/frame (PIO pull数と一致)
2026-02-11 Layer 5: framebuffer + double buffering
    - Add src/lcd/framebuffer.rs: FrameBuffer struct with 512x96 padded layout
    - rgb666/reverse6 helpers (moved from layer3/4 inline)
    - set_pixel/get_pixel with bounds check + debug_assert
    - row_slice for DMA transfer with debug_assert
    - clear for active region only
    - Add src/bin/layer5_framebuffer.rs: double-buffered display
    - Channel-based safe buffer swap at VSYNC boundary
    - DisplayPeripherals struct (embassy 16-arg limit workaround)
    - Gradient animation demo
    - Update src/lcd/mod.rs: add framebuffer module
    - Update Cargo.toml: add layer5_framebuffer binary
2026-02-11 docs: update implementation plan and setup guide for Layer 5
    - Mark Layer 5 as completed in implementation-plan.md
    - Add framebuffer architecture details (512x96 padded, Channel-based double buffering)
    - Add memory usage stats (384KB/520KB = 74%)
    - Add layer5_framebuffer build target to setup-guide.md
2026-02-11 Layer 6: embedded-graphics DrawTarget implementation
    - Add DrawTarget<Color=Rgb666> impl to FrameBuffer
    - draw_iter: coordinate clipping with bounds constants
    - fill_solid: optimized slice fill with Rectangle intersection
    - clear: active region only, padding preserved
    - Add OriginDimensions impl (400x96)
    - Add src/bin/layer6_drawtest.rs: text, shapes, colorbar demo
    - Channel-based double buffering (same as Layer 5)
    - FONT_6X10 text rendering
    - Rectangle, Circle, Line primitives
    - SMPTE 8-color bar
    - Update Cargo.toml: add layer6_drawtest binary
2026-02-11 fix: NCLK sideset反転でテキスト描画崩れを修正
    LCD (LTA042B010F) はNCLKの立ち下がりエッジでデータをサンプルする。
    旧PIOプログラムでは `out pins, 18 side 0` でデータ変更とNCLK立ち下がりが
    同時に発生し、セットアップ時間が0だった。
    sideset値を反転 (side 0/1 → side 1/0) することで、データ出力時はNCLK=HIGH
    （セットアップ期間）、その後のnopでNCLK=LOW（立ち下がりエッジ）とすることで
    約145nsのセットアップ時間を確保。
    これにより、疎なピクセルパターン（テキスト等）で頻繁にデータが変化する場合でも
    LCDが安定したデー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
2026-02-12 feat: Layer 7 全フレームDMA転送方式を追加
    - SM0（ピクセル+NCLK）とSM1（HSYNC/VSYNC）をMULTI_CHAN_TRIGGERで同時DMA起動
    - フレームバッファを512×112に拡張（V-blank 16行含む）
    - SM1タイミングデータ（225ワード）の一括DMA転送
    - 行間のCPU介入を排除しジッターを大幅軽減
    - DMA再設定をクリティカルセクションで保護
    残存する1ピクセルブレは配線品質が主因（クロック1/3で検証済み）
2026-02-16 docs(lcd): PIOプログラムのサイドセット極性ドキュメントを修正
    - pio_program.rs のコメント中の極性記述をLayer7実装と整合
    - side 1 (NCLK=HIGH) でデータセットアップ
    - side 0 (NCLK=LOW) への立ち下がりでLCDサンプル
    - コード変更なし(ドキュメントのみ)
2026-08-14 feat(kicad): add reviewed Pico LCD carrier design
    [pico_lta042b010f_carrier.kicad_pcb, pico_lta042b010f_carrier.kicad_sch]
2026-08-14 refactor(kicad): clean schematic junctions
    [pico_lta042b010f_carrier.kicad_sch]
2026-08-14 docs(kicad): add Codex schematic workflow skill
    [pico_lta042b010f_carrier.kicad_sch]
2026-08-14 fix(kicad): clean power schematic routing
    [pico_lta042b010f_carrier.kicad_sch]
2026-08-14 fix(kicad): refine schematic layout feedback
    [pico_lta042b010f_carrier.kicad_sch]
2026-08-14 feat(kicad): group Pico LCD signals into buses
    [pico_lta042b010f_carrier.kicad_sch]
2026-08-16 fix(kicad): improve Pico symbol readability
    [pico_lta042b010f_carrier.kicad_sch]
2026-08-16 chore: ignore Codex workspace attachments
2026-08-30 chore(kicad): checkpoint before PCB artwork
    [pico_lta042b010f_carrier-bom.csv, pico_lta042b010f_carrier.kicad_pcb, pico_lta042b010f_carrier.kicad_sch]
2026-09-08 Update hand-solder components and preserve current PCB layout
    [pico_lta042b010f_carrier-bom.csv, pico_lta042b010f_carrier.kicad_pcb, pico_lta042b010f_carrier.kicad_sch]
2026-09-16 Update power-stage layout and component selections
    [pico_lta042b010f_carrier-bom.csv, pico_lta042b010f_carrier.kicad_pcb, pico_lta042b010f_carrier.kicad_sch]
2026-09-16 Constrain power components to red placement zone
    [pico_lta042b010f_carrier.kicad_pcb]
2026-09-16 Update power stage for vertical parts and USB-C input
    [pico_lta042b010f_carrier-bom.csv, pico_lta042b010f_carrier.kicad_pcb, pico_lta042b010f_carrier.kicad_sch]
2026-09-16 Use compact Akizuki USB-C power connector
    [pico_lta042b010f_carrier-bom.csv, pico_lta042b010f_carrier.kicad_pcb, pico_lta042b010f_carrier.kicad_sch]
2026-09-16 Optimize and route power stage
    [pico_lta042b010f_carrier.kicad_pcb]
2026-09-16 Route Pico and LCD connections
    [pico_lta042b010f_carrier.kicad_pcb]
2026-09-16 Tighten PCB design rules and edge margins
    [pico_lta042b010f_carrier.kicad_pcb]
2026-09-17 Add dual-layer thermal ground pours
    [pico_lta042b010f_carrier.kicad_pcb]
2026-09-17 Widen 13V rails across PCB
    [pico_lta042b010f_carrier.kicad_pcb]
2026-09-17 Optimize J1 bias rail routing
    [pico_lta042b010f_carrier.kicad_pcb]
2026-09-17 Clean up silkscreen and add board ID
    [pico_lta042b010f_carrier.kicad_pcb]
2026-10-04 Add standalone Pico 2 W Matter power probe
2026-10-04 Integrate ticker and P110M Matter power firmware v0.6.1
2026-10-05 Add configurable power display and time-range graphs
2026-10-05 Fix power widget text clipping and verify layout bounds
    [tests.rs]
2026-10-05 Restore decimal points in large power readouts
2026-10-08 Refine power and settings layouts for v0.6.4
